paszkowskiDamian/tendon-torso/README.md

# Tendon Torso

An open, fully 3D-printed **tendon-driven torso with two arms**. All motors sit in the torso, and the tendons run hidden through the hollow core of every link, through shoulder, elbow and wrist, down to simple grippers.

We build it up one joint at a time.

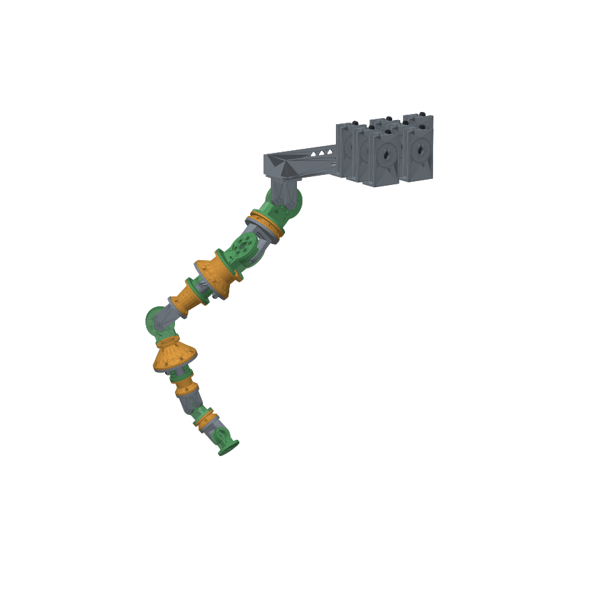
[picture p1: docs/img/arm_assembly.png]
7-DOF tendon arm


## Status

| Part | Status |
|---|---|
| [J1: 1-DOF tendon hinge test rig](joints/j1-hinge/) | designed, STL ready, **not printed/tested yet** |
| [J1-S: NEMA17, 6:1 tendon reduction, Bowden-ready center](joints/j1s-hinge/) | designed, STL ready, **not printed/tested yet** |
| [J1b: 2-DOF, J1-S elbow + J2 wrist, both motors remote (J2 via Bowden)](joints/j1b-2dof/) | designed, STL ready, **not printed/tested yet** |
| [**Two 7-DOF arms + grippers on a torso**](arm/), shoulder (3), elbow, forearm twist, wrist (2), two-finger gripper on one cord; 16 servo drive units in the torso column | designed, all 57 part files print-ready and CAD-checked, **not printed yet** |
| Second arm, motors | see [roadmap](docs/roadmap.md) |
| [MuJoCo simulation](docs/sim.md): both arms on the torso, pick-and-place scene, scripted IK demos, LeRobot dataset recording, ACT training + evaluation | runs; scripted demos 100 %, ACT policy trained in sim 84 % on unseen scenes |

## Interactive viewer

An animated 3D assembly showing how the tendons wind is in [`docs/viewer/`](docs/viewer/). Run `python3 -m http.server -d docs/viewer` and open http://localhost:8000.

## Repo layout

```
docs/research.md      existing open designs + why J1 looks the way it does
docs/roadmap.md       path to the torso, the tendon-routing problem
joints/j1-hinge/      J1 (servo, 1:1): CadQuery source, STL/STEP, build guide
joints/j1s-hinge/     J1-S (stepper, 6:1, Bowden center)
joints/j1b-2dof/      J1b: J1-S + J2 wrist module + Bowden drive module
joints/common/        shared CAD helpers
arm/                  the two 7-DOF arms + grippers: modules, links, gripper, drive units, torso, STLs, build guide
arm/kinematics.py     forward + inverse kinematics (python -m arm.ik X Y Z), see docs/kinematics.md
sim/                  MuJoCo model built from the CAD, pick-and-place env, demo recorder, policy evaluator (docs/sim.md)
tools/                preview renders + collision / clearance checks
```

## Building the CAD

Everything is parametric Python ([CadQuery](https://cadquery.readthedocs.io/)). Change a number, then regenerate:

```bash
python3 -m venv .venv && .venv/bin/pip install -r requirements.txt
.venv/bin/python joints/j1-hinge/j1_hinge.py
.venv/bin/python tools/render.py
```

STEP files open in Fusion, FreeCAD, Onshape or Rhino.

## License

[MIT](LICENSE): use it, remix it, sell it, just keep the notice. Contributions and build reports are welcome.
