paszkowskiDamian/tendon-torso/docs/loads_report.txt

Arm mass: 1039 g printed (links 15%, modules 25% infill) + 593 g hardware = 1.63 kg  (+ 0.3 kg payload at the tool)

element         mass g
S1                 317
link_s1_s2          62
S2                 306
link_s2_s3          77
S3                 173
link_upper          55
E                  150
link_e_f            62
F                  136
link_forearm        32
W1                  95
link_w1_w2          25
W2                  91
gripper             51

Worst case over the workspace (1500 random poses + horizontal poses):
joint torque N*m   cord N  knob N  bearing N   pose (S1..W2)
S1          8.29      217    28.1        221   [90.0, 0.0, 0.0, 0.0, 0.0, 0.0, 0.0]
S2          5.72      156    20.1        202   [0.0, 90.0, 0.0, 0.0, 0.0, 0.0, 0.0]
S3          2.48      109    14.0        183   [68.0, 70.0, -70.0, 94.0, 1.0, 2.0, -11.0]
E           2.52       90    11.6        131   [90.0, 0.0, 0.0, 0.0, 0.0, 0.0, 0.0]
F           0.73       49     6.3         85   [112.0, -5.0, 70.0, 38.0, 39.0, -60.0, -3.0]
W1          0.86       63     8.2         73   [90.0, 0.0, 0.0, 0.0, 0.0, 0.0, 0.0]
W2          0.38       39     5.0         46   [0.0, 90.0, 0.0, 0.0, 0.0, 0.0, 0.0]

element         bend N*m  stress MPa  bolt N
S1                  8.29                  45
link_s1_s2          7.05         0.8      38
S2                  6.71                  36
link_s2_s3          4.91         0.5      27
S3                  4.20                  23
link_upper          3.68         1.4      25
E                   3.08                  57
link_e_f            2.06         0.8      38
F                   1.65                   9
link_forearm        1.34         0.5      25
W1                  1.11                  21
link_w1_w2          0.67         0.3      12
W2                  0.57                  11
gripper             0.23                   4
