paszkowskiDamian/tendon-torso/docs/img/j1_base.png

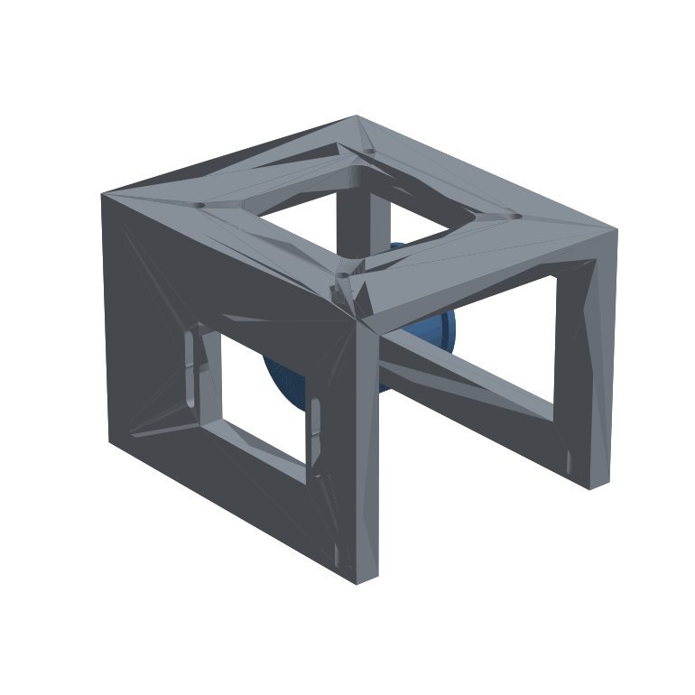
docs/img/j1_base.png
