paszkowskiDamian/tendon-torso/docs/img/j1_proximal.png

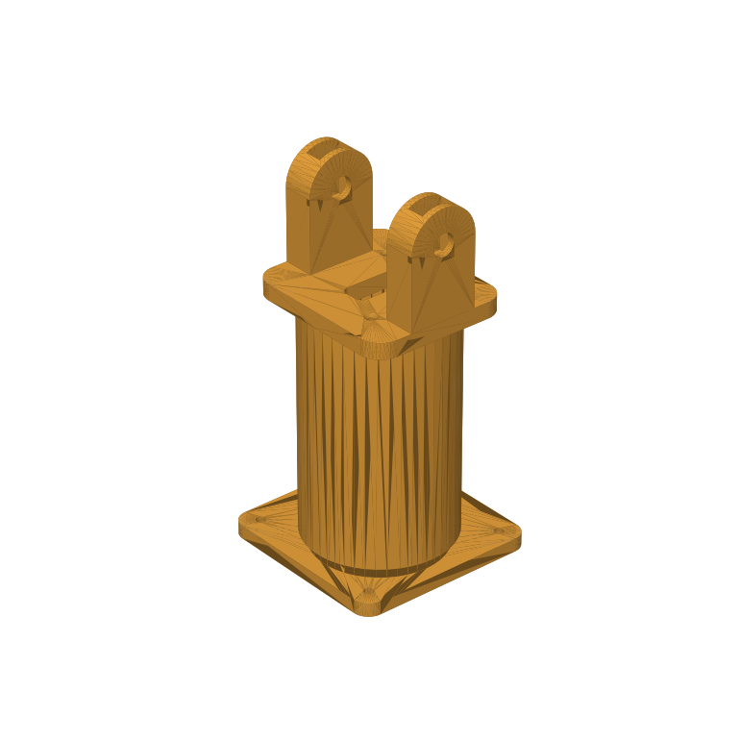
docs/img/j1_proximal.png
