paszkowskiDamian/tendon-torso/docs/img/j1_spool.png

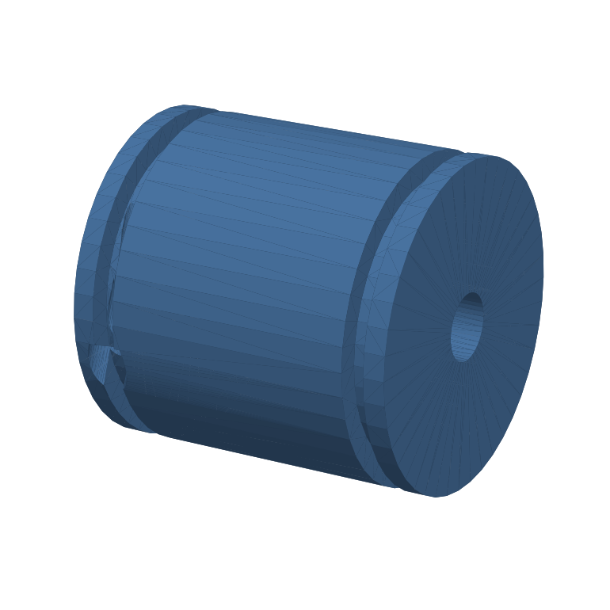
docs/img/j1_spool.png
