paszkowskiDamian/tendon-torso/docs/img/j1s_base.png

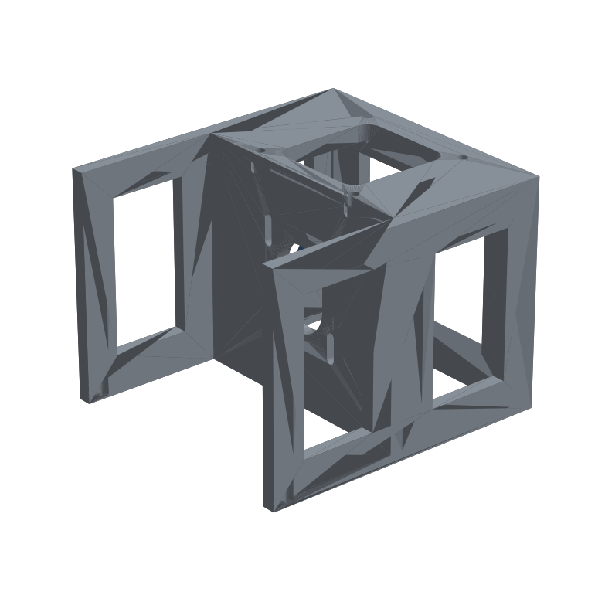
docs/img/j1s_base.png
