paszkowskiDamian/tendon-torso/docs/img/j1s_spool.png

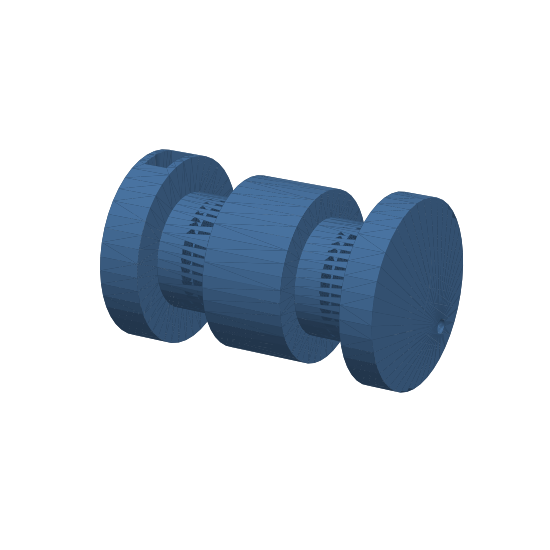
docs/img/j1s_spool.png
