paszkowskiDamian/tendon-torso/docs/img/workspace_heights.png

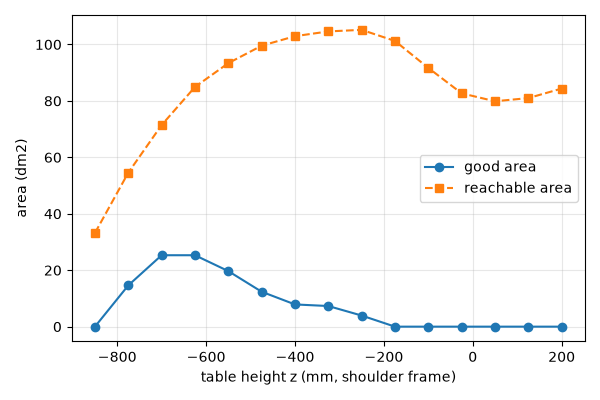
docs/img/workspace_heights.png
