paszkowskiDamian/tendon-torso/docs/img/workspace_plane.png

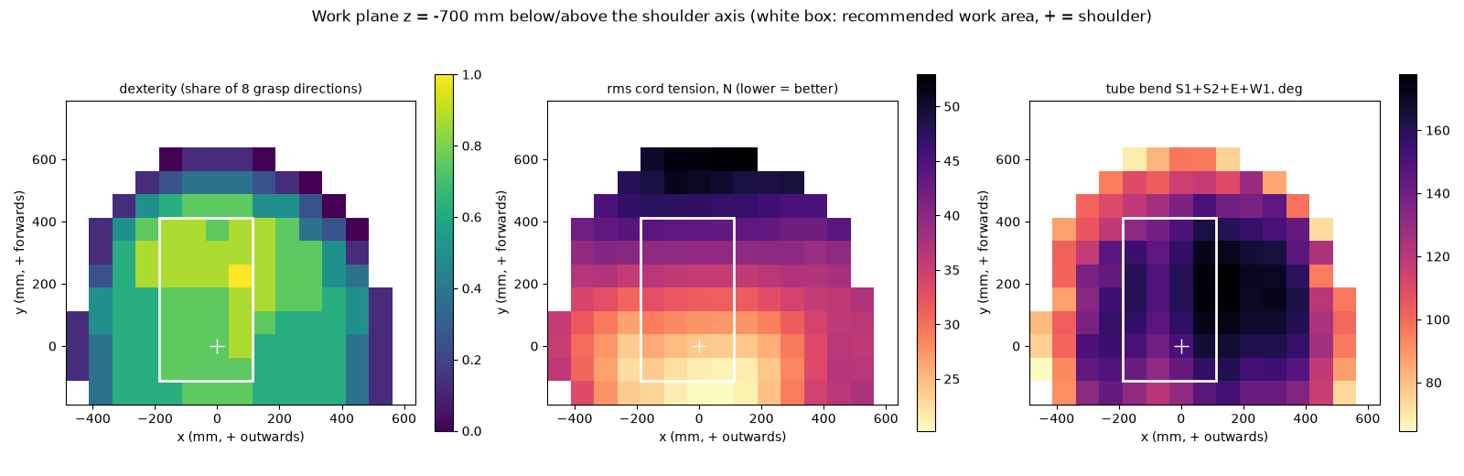
docs/img/workspace_plane.png
