paszkowskiDamian/tendon-torso/joints/j1b-2dof/stl/assembly_preview.step

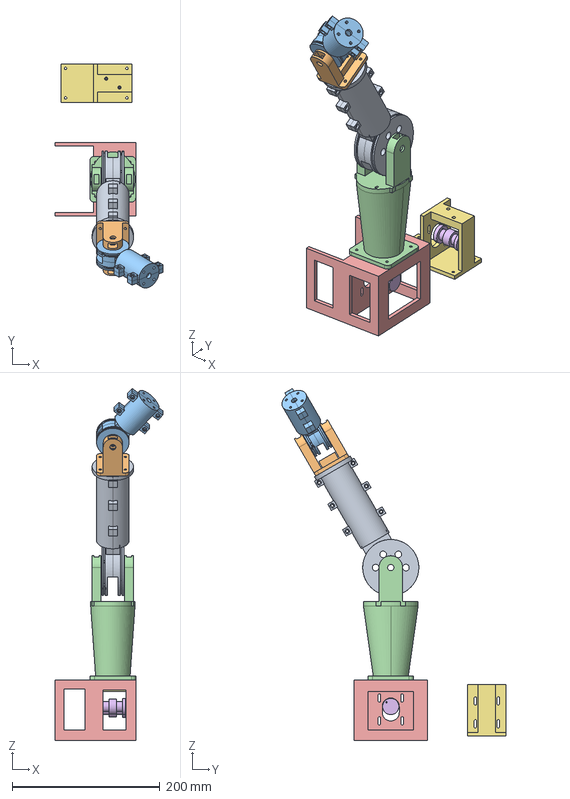
[picture p17: CAD file, 2026-11-10]
joints/j1b-2dof/stl/assembly_preview.step
145.6 x 303.2 x 476.3 mm
