paszkowskiDamian/tendon-torso/joints/j1s-hinge/stl/assembly_preview.step

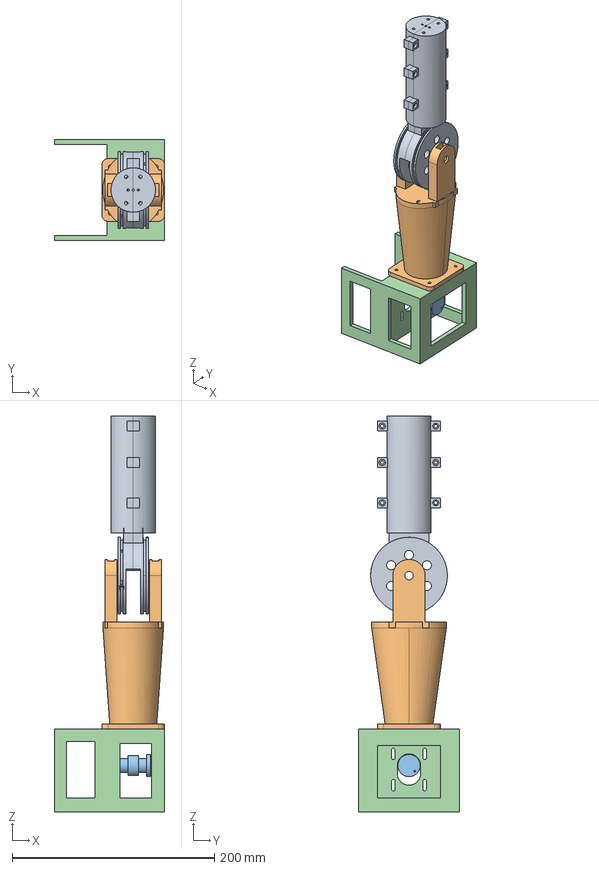
[picture p18: CAD file, 2026-11-10]
joints/j1s-hinge/stl/assembly_preview.step
109.0 x 100.0 x 392.0 mm
