paszkowskiDamian/tendon-torso/arm/stl/torso_saddle.stl

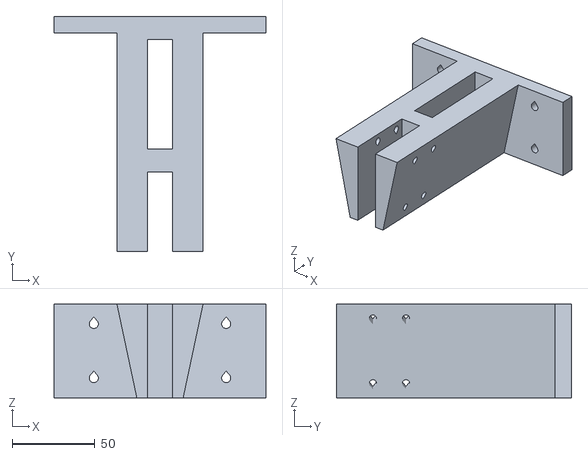
[picture p19: CAD file, 2026-11-11]
arm/stl/torso_saddle.stl
128.0 x 142.0 x 56.7
