paszkowskiDamian/tendon-torso/joints/j1b-2dof/stl/j2_mount.step

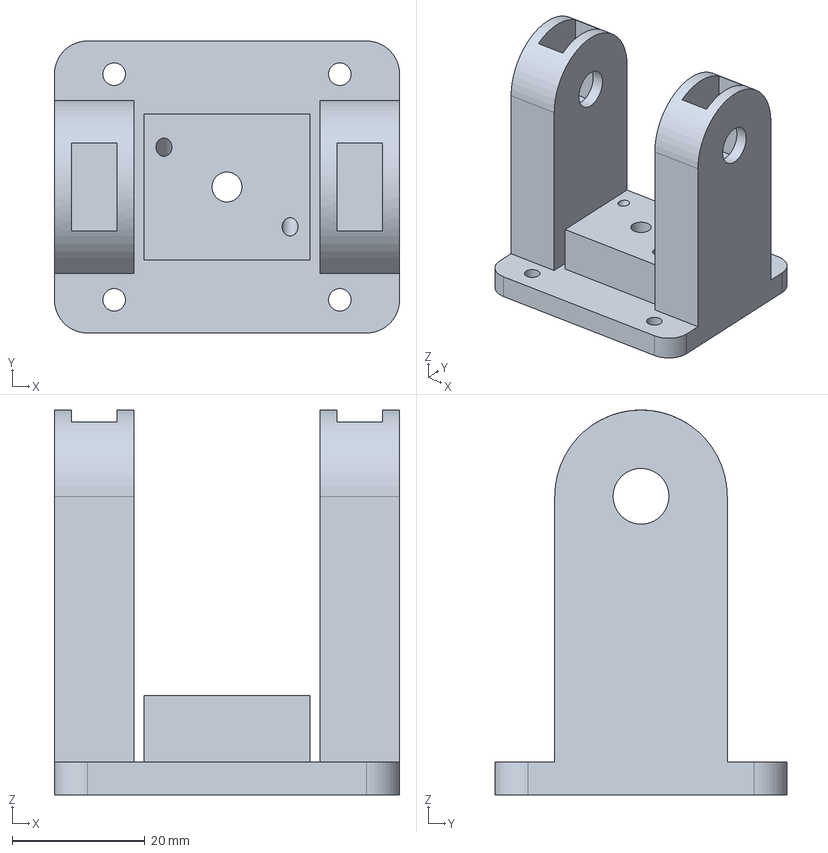
[picture p20: CAD file, 2026-11-10]
joints/j1b-2dof/stl/j2_mount.step
52.0 x 44.0 x 58.0 mm
