paszkowskiDamian/tendon-torso/joints/j1s-hinge/stl/proximal.step

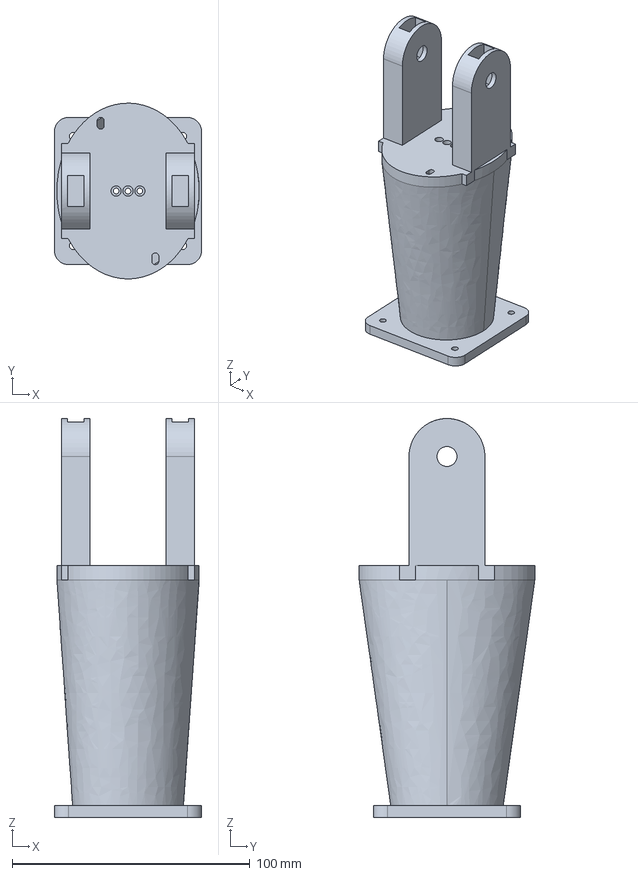
[picture p21: CAD file, 2026-11-10]
joints/j1s-hinge/stl/proximal.step
62.0 x 74.0 x 168.0 mm
