paszkowskiDamian/tendon-torso/sim/assets/s2_base_l.stl

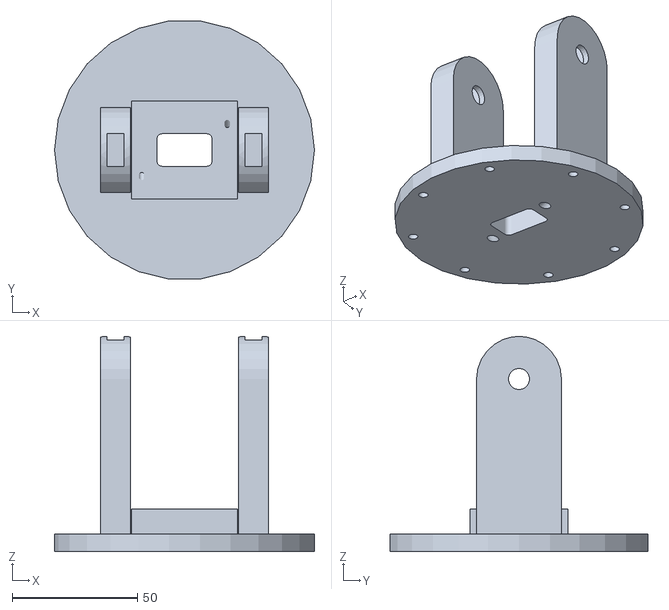
[picture p22: CAD file, 2026-11-11]
sim/assets/s2_base_l.stl
104.0 x 103.2 x 86.0
