paszkowskiDamian/tendon-torso/arm/stl/balance_post.stl

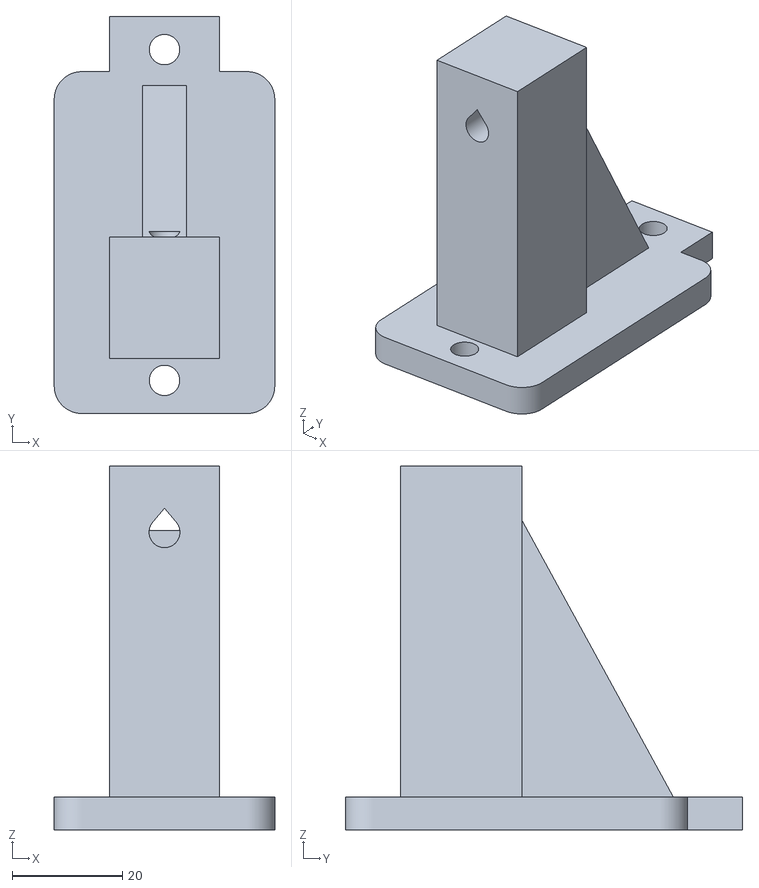
[picture p23: CAD file, 2026-11-11]
arm/stl/balance_post.stl
40.0 x 72.0 x 66.0
