paszkowskiDamian/tendon-torso/joints/j1b-2dof/stl/j2_distal_half.step

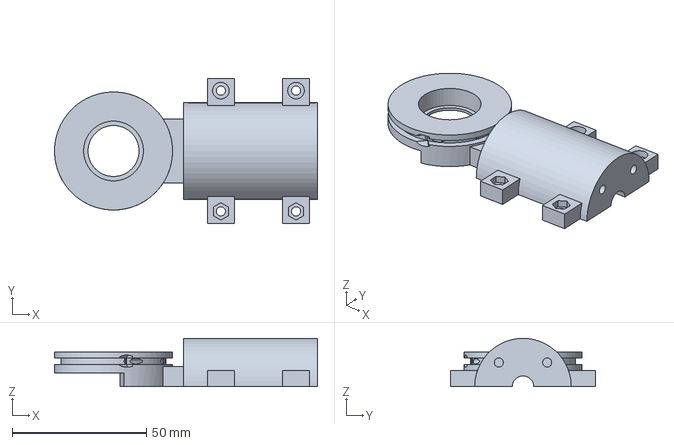
[picture p24: CAD file, 2026-11-10]
joints/j1b-2dof/stl/j2_distal_half.step
98.0 x 54.0 x 18.0 mm
