paszkowskiDamian/tendon-torso/joints/j1s-hinge/stl/base.step

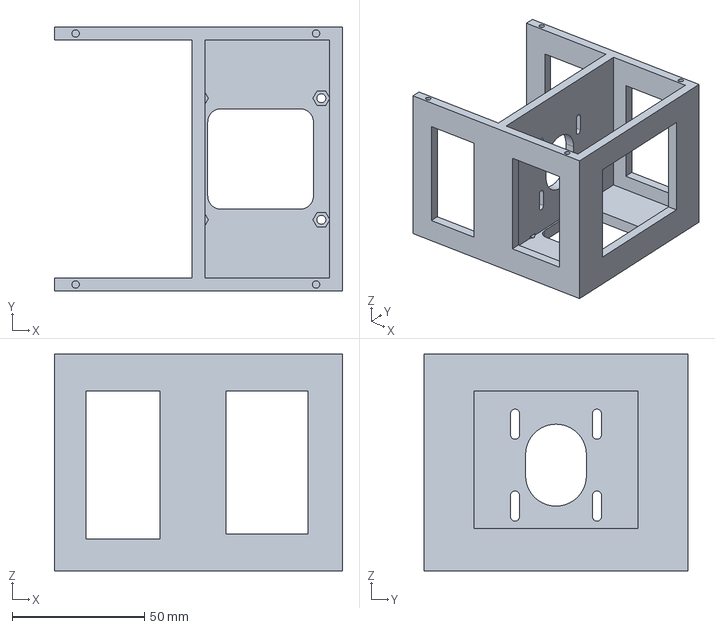
[picture p25: CAD file, 2026-11-10]
joints/j1s-hinge/stl/base.step
109.0 x 100.0 x 82.0 mm
