paszkowskiDamian/tendon-torso/sim/assets/s3_rotor_l.stl

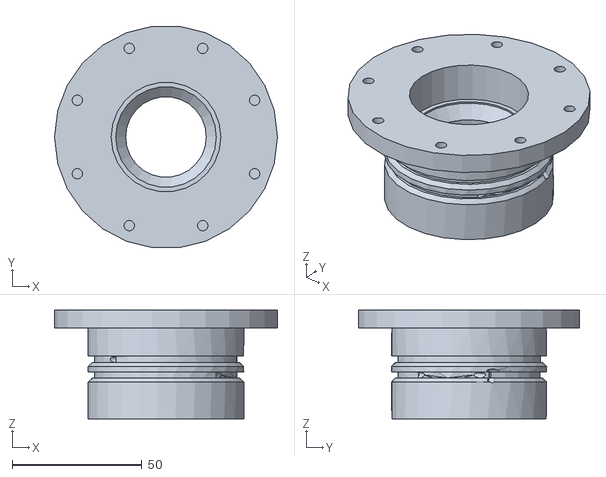
[picture p26: CAD file, 2026-11-11]
sim/assets/s3_rotor_l.stl
86.0 x 85.4 x 42.0
