paszkowskiDamian/tendon-torso/arm/stl/torso_shoulder_beam.stl

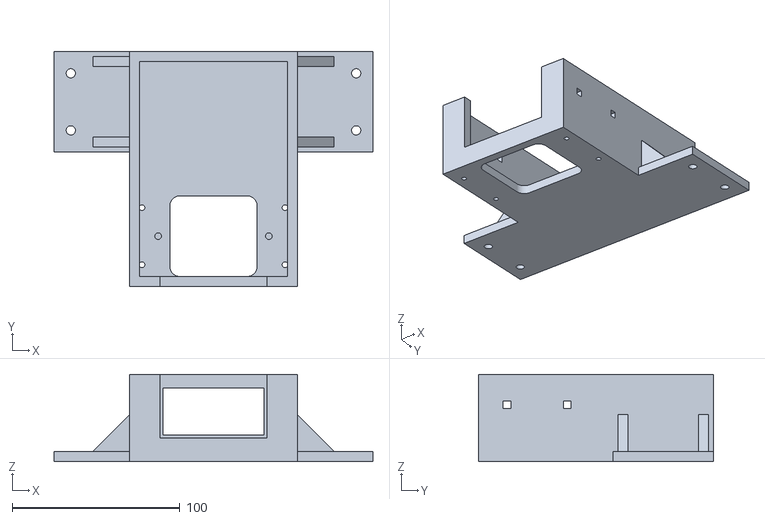
[picture p27: CAD file, 2026-11-11]
arm/stl/torso_shoulder_beam.stl
190.0 x 140.0 x 52.0
