paszkowskiDamian/tendon-torso/joints/j1s-hinge/stl/distal_half.step

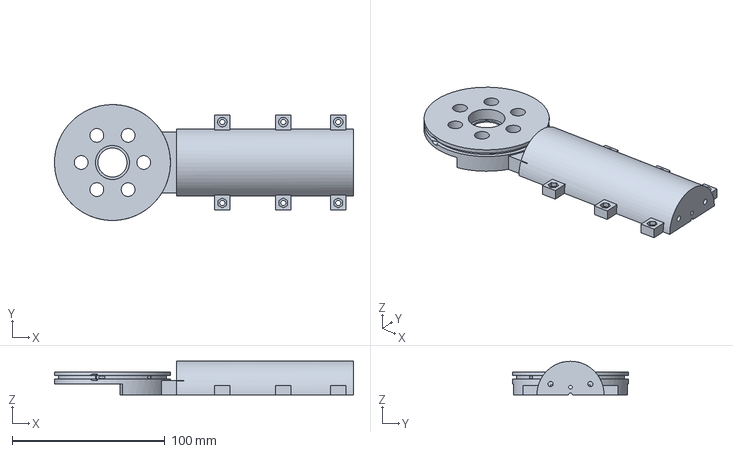
[picture p28: CAD file, 2026-11-10]
joints/j1s-hinge/stl/distal_half.step
196.0 x 76.0 x 22.0 mm
