paszkowskiDamian/tendon-torso/sim/assets/gripper_finger_b_l.stl

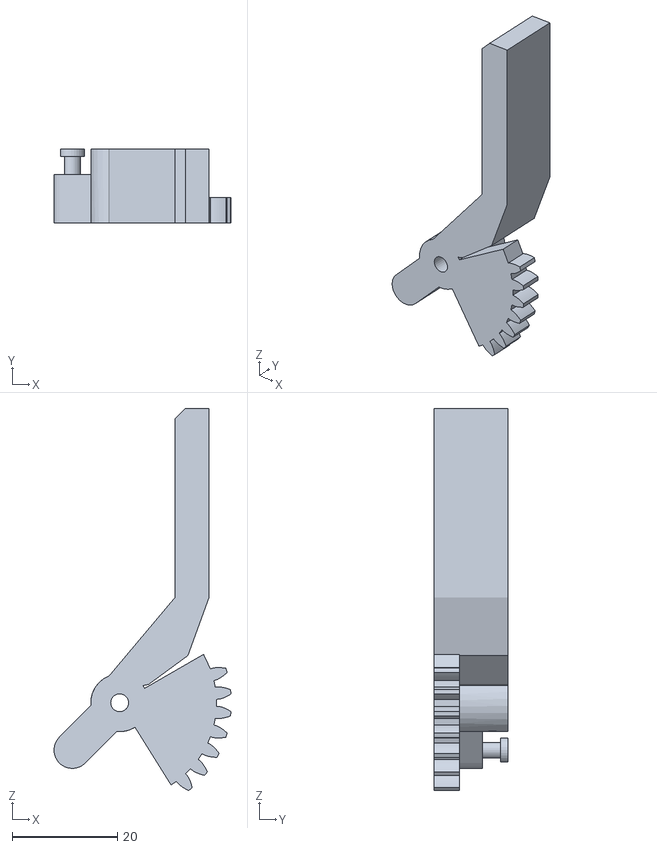
[picture p29: CAD file, 2026-11-11]
sim/assets/gripper_finger_b_l.stl
33.7 x 14.0 x 72.7
