paszkowskiDamian/tendon-torso/arm/stl/drive_adapter_sts3215.stl

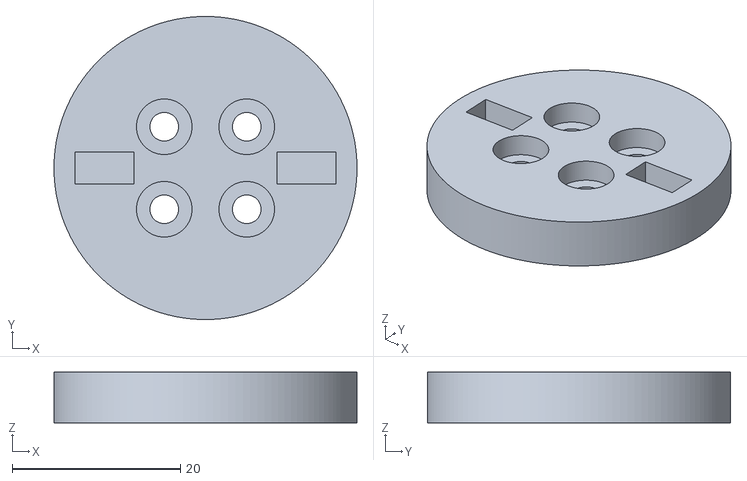
[picture p30: CAD file, 2026-11-11]
arm/stl/drive_adapter_sts3215.stl
36.0 x 36.0 x 6.00
