paszkowskiDamian/tendon-torso/joints/j1s-hinge/stl/spool.step

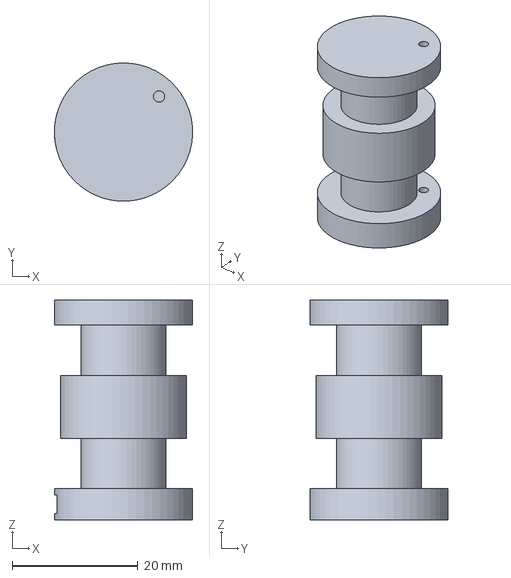
[picture p31: CAD file, 2026-11-10]
joints/j1s-hinge/stl/spool.step
22.0 x 22.0 x 35.0 mm
