paszkowskiDamian/tendon-torso/sim/assets/link_forearm_r.stl

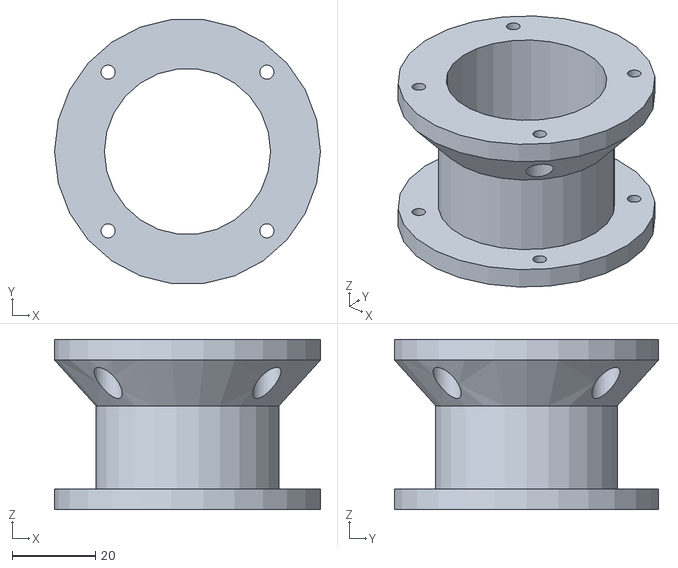
[picture p32: CAD file, 2026-11-11]
sim/assets/link_forearm_r.stl
64.0 x 63.5 x 41.0
