paszkowskiDamian/tendon-torso/arm/stl/torso_electronics_tray.stl

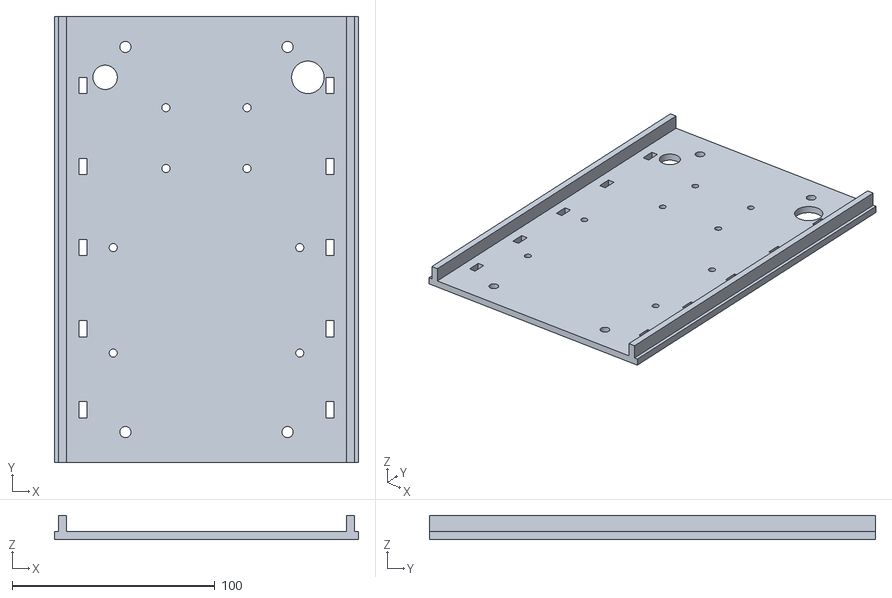
[picture p33: CAD file, 2026-11-11]
arm/stl/torso_electronics_tray.stl
150.0 x 220.0 x 12.0
