paszkowskiDamian/tendon-torso/joints/j1b-2dof/stl/bowden_drive.step

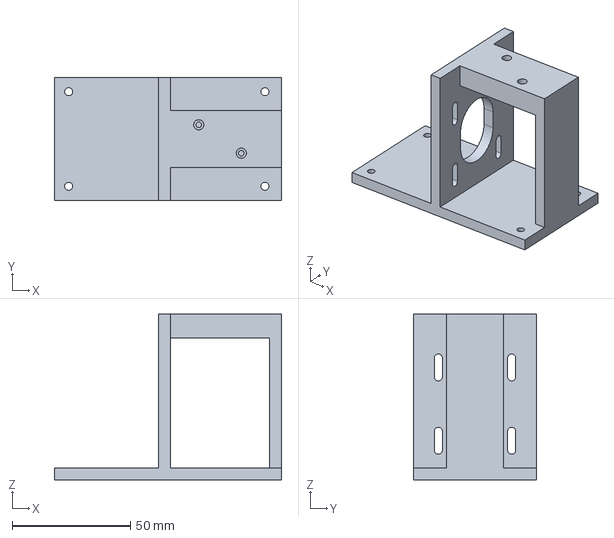
[picture p34: CAD file, 2026-11-10]
joints/j1b-2dof/stl/bowden_drive.step
96.0 x 52.0 x 70.0 mm
