paszkowskiDamian/tendon-torso/sim/assets/w1_base_l.stl

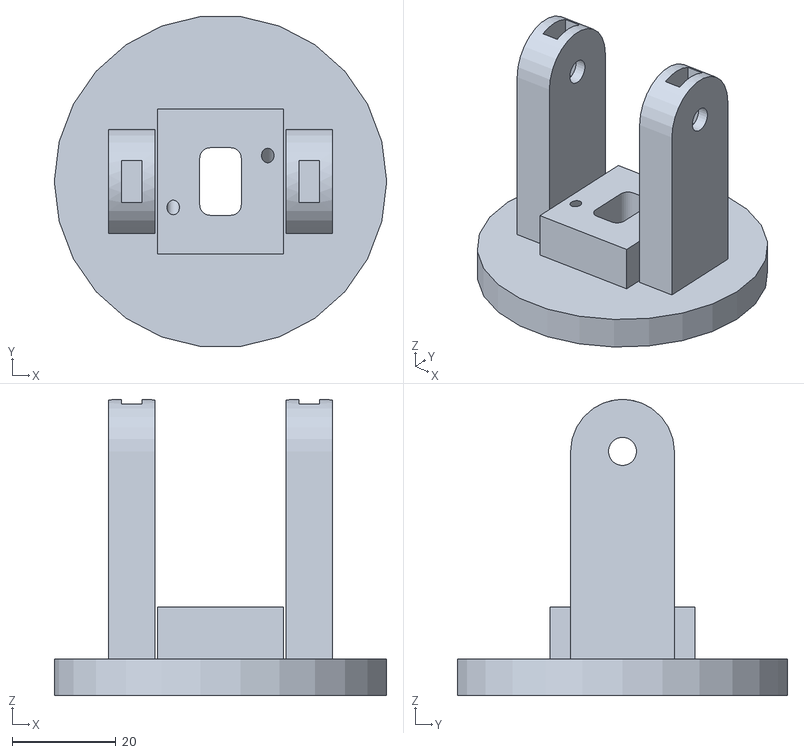
[picture p35: CAD file, 2026-11-11]
sim/assets/w1_base_l.stl
64.0 x 63.5 x 57.0
