paszkowskiDamian/tendon-torso/arm/stl/drive_frame.stl

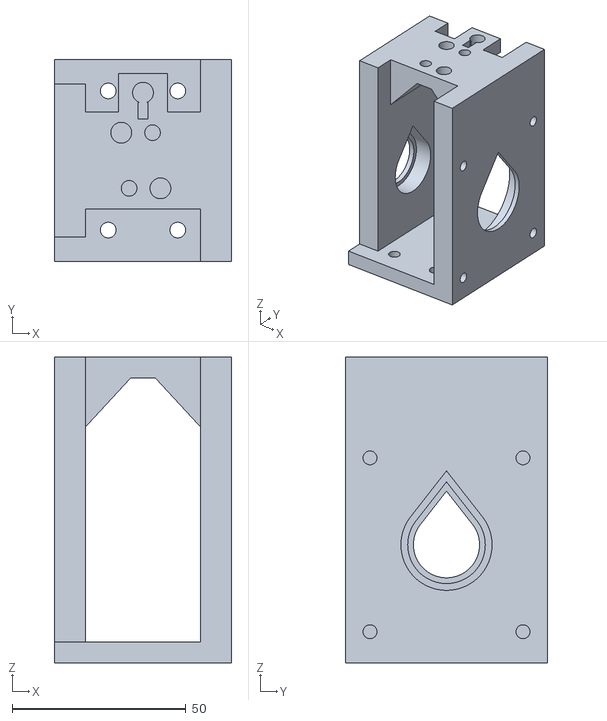
[picture p36: CAD file, 2026-11-11]
arm/stl/drive_frame.stl
51.0 x 58.0 x 88.0
