paszkowskiDamian/tendon-torso/joints/j1b-2dof/stl/j1_distal_half_mount.step

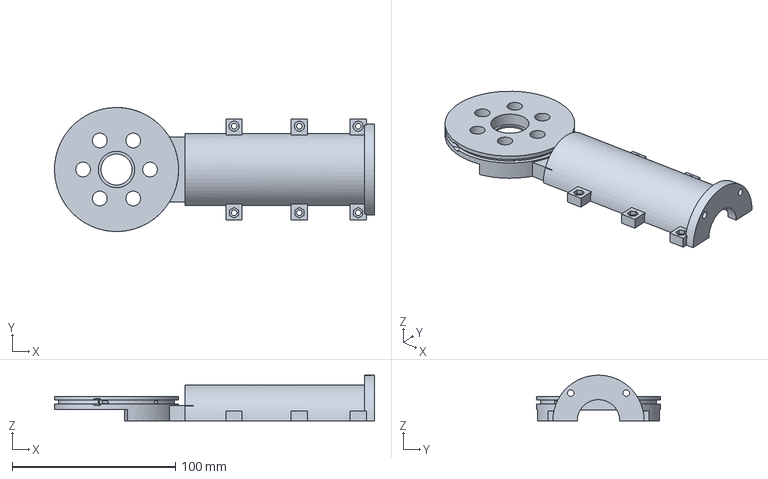
[picture p37: CAD file, 2026-11-10]
joints/j1b-2dof/stl/j1_distal_half_mount.step
196.0 x 76.0 x 28.0 mm
