paszkowskiDamian/tendon-torso/arm/stl/torso_shoulder_comb.stl

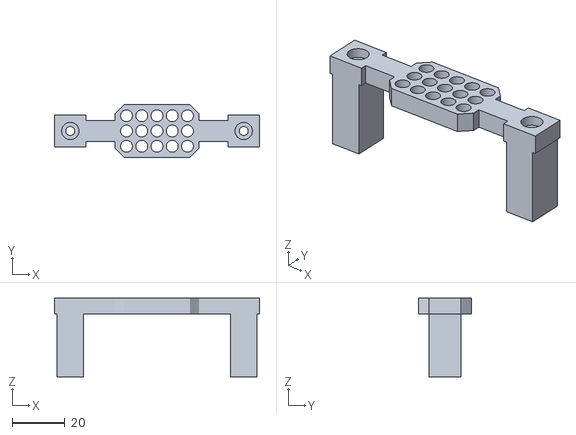
[picture p38: CAD file, 2026-11-11]
arm/stl/torso_shoulder_comb.stl
78.0 x 20.0 x 30.0
