paszkowskiDamian/tendon-torso/sim/assets/gripper_pad_b_r.stl

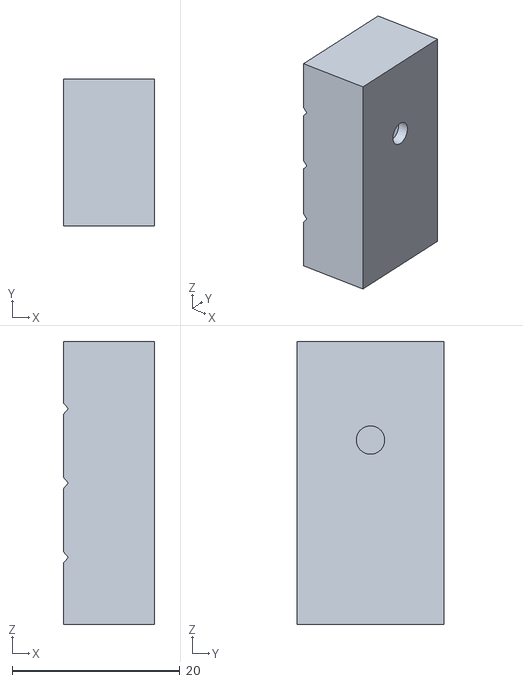
[picture p39: CAD file, 2026-11-11]
sim/assets/gripper_pad_b_r.stl
10.9 x 17.5 x 33.8
