paszkowskiDamian/tendon-torso/arm/stl/drive_adapter_dmj4310.stl

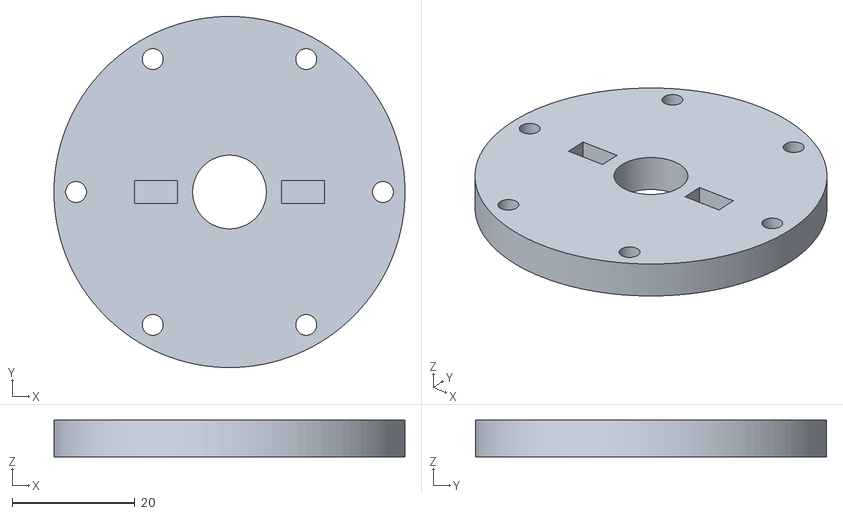
[picture p40: CAD file, 2026-11-11]
arm/stl/drive_adapter_dmj4310.stl
57.2 x 57.2 x 6.00
