paszkowskiDamian/tendon-torso/sim/assets/s2_rotor_a_l.stl

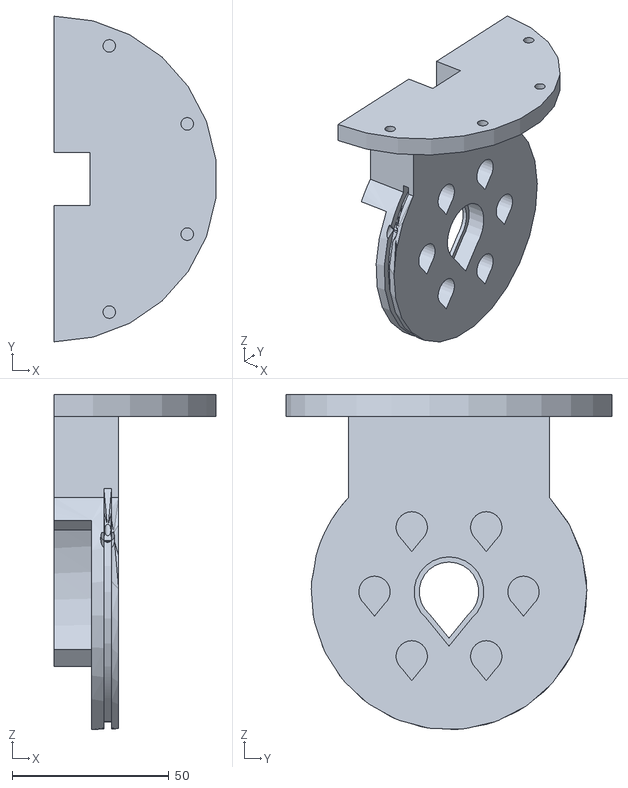
[picture p41: CAD file, 2026-11-11]
sim/assets/s2_rotor_a_l.stl
51.6 x 104.0 x 107.0
