paszkowskiDamian/tendon-torso/arm/stl/torso_s1_hanger.stl

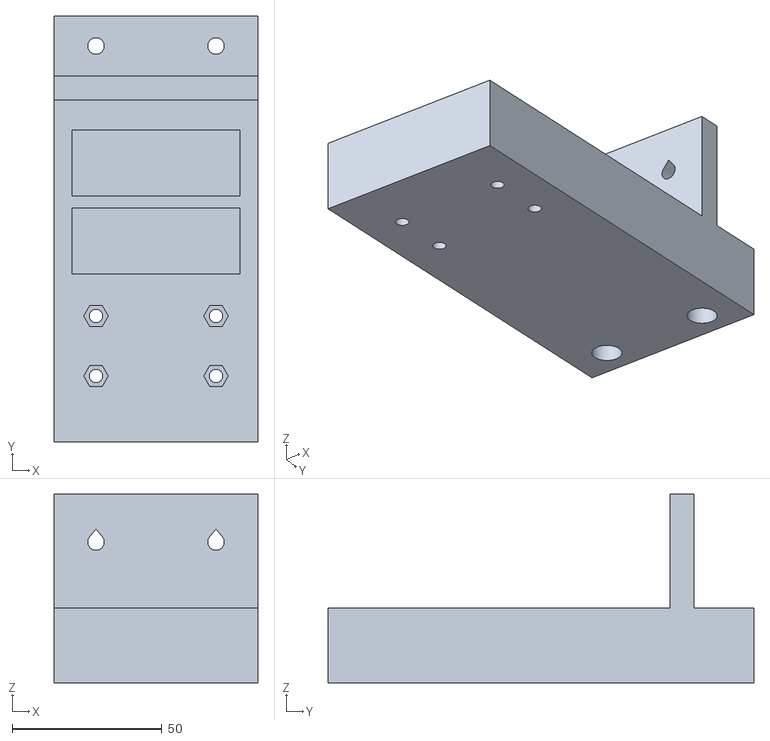
[picture p42: CAD file, 2026-11-11]
arm/stl/torso_s1_hanger.stl
68.0 x 142.0 x 63.0
