paszkowskiDamian/tendon-torso/sim/assets/f_idler_b_l.stl

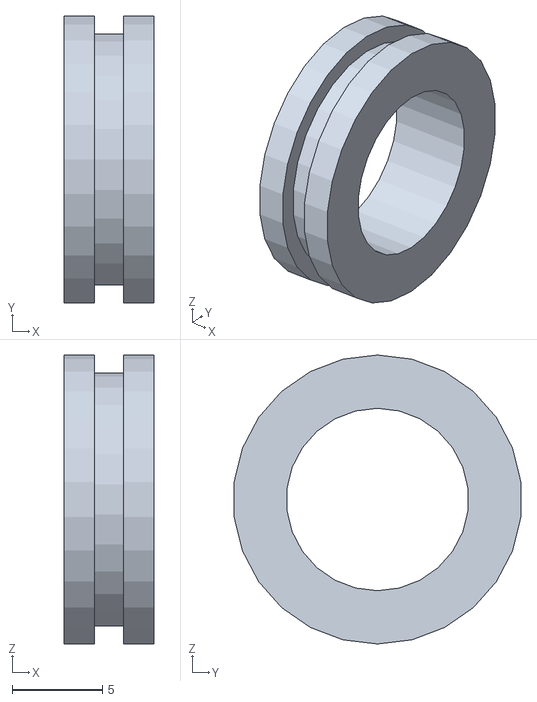
[picture p43: CAD file, 2026-11-11]
sim/assets/f_idler_b_l.stl
5.00 x 15.9 x 16.0
