paszkowskiDamian/tendon-torso/arm/stl/drive_cup_sts3250.stl

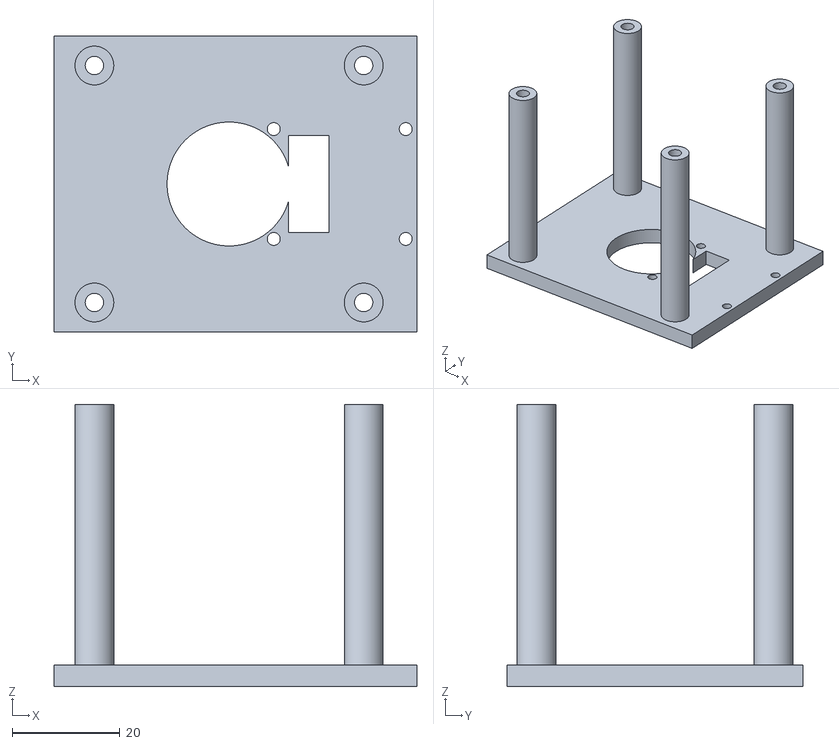
[picture p44: CAD file, 2026-11-11]
arm/stl/drive_cup_sts3250.stl
67.4 x 55.0 x 52.4
