paszkowskiDamian/tendon-torso/sim/assets/s3_stator_l.stl

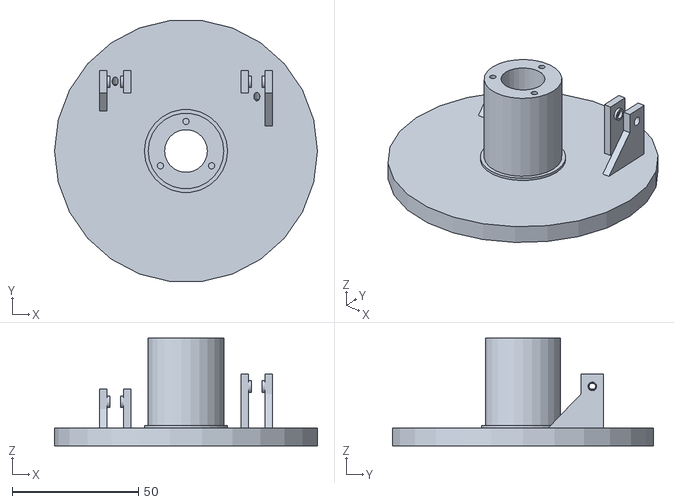
[picture p45: CAD file, 2026-11-11]
sim/assets/s3_stator_l.stl
104.0 x 103.2 x 42.6
