paszkowskiDamian/tendon-torso/sim/assets/gripper_finger_a_r.stl

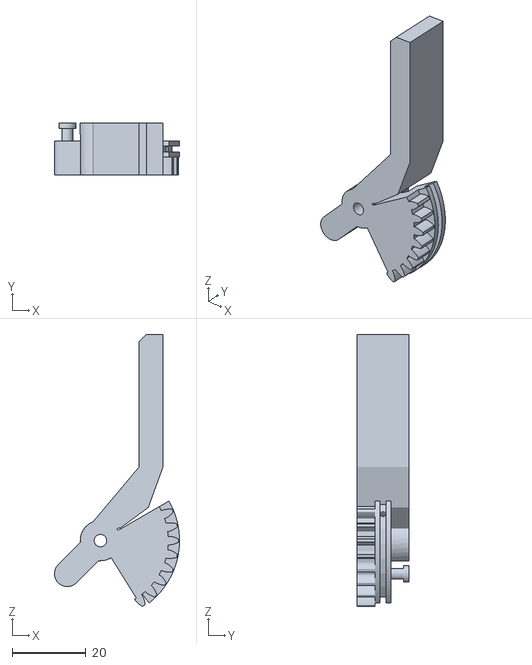
[picture p46: CAD file, 2026-11-11]
sim/assets/gripper_finger_a_r.stl
34.0 x 14.0 x 73.9
