paszkowskiDamian/tendon-torso/arm/stl/drive_spool.stl

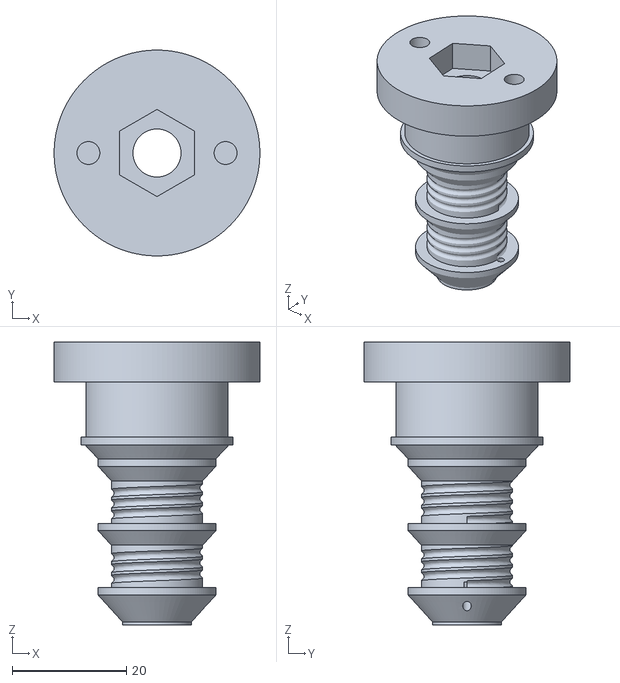
[picture p47: CAD file, 2026-11-11]
arm/stl/drive_spool.stl
36.0 x 36.0 x 49.5
