paszkowskiDamian/tendon-torso/sim/assets/link_e_f_r.stl

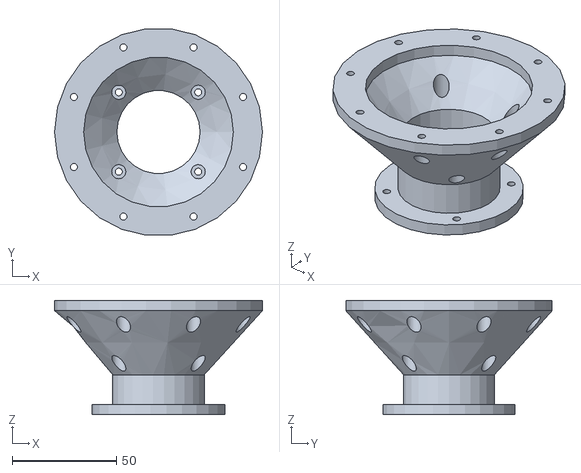
[picture p48: CAD file, 2026-11-11]
sim/assets/link_e_f_r.stl
100.0 x 99.3 x 55.0
