paszkowskiDamian/tendon-torso/arm/stl/drive_cup_dmj4310.stl

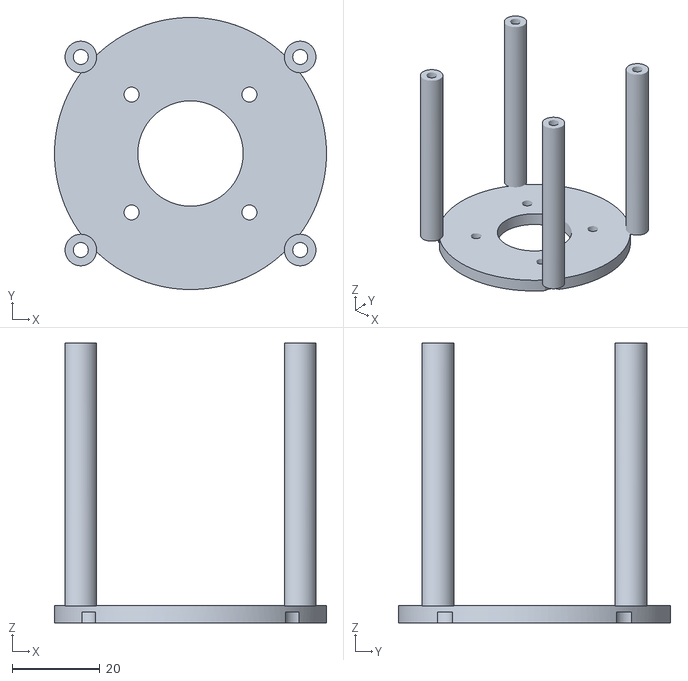
[picture p49: CAD file, 2026-11-11]
arm/stl/drive_cup_dmj4310.stl
62.0 x 62.0 x 63.8
