paszkowskiDamian/tendon-torso/sim/assets/f_stator_r.stl

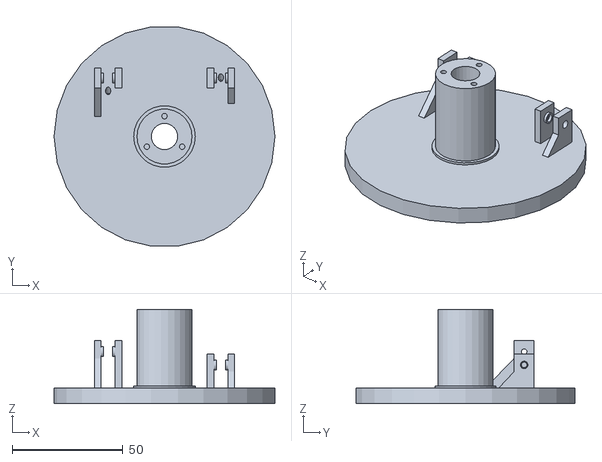
[picture p50: CAD file, 2026-11-11]
sim/assets/f_stator_r.stl
100.0 x 99.3 x 42.6
