paszkowskiDamian/tendon-torso/arm/stl/drive_cup_sts3095.stl

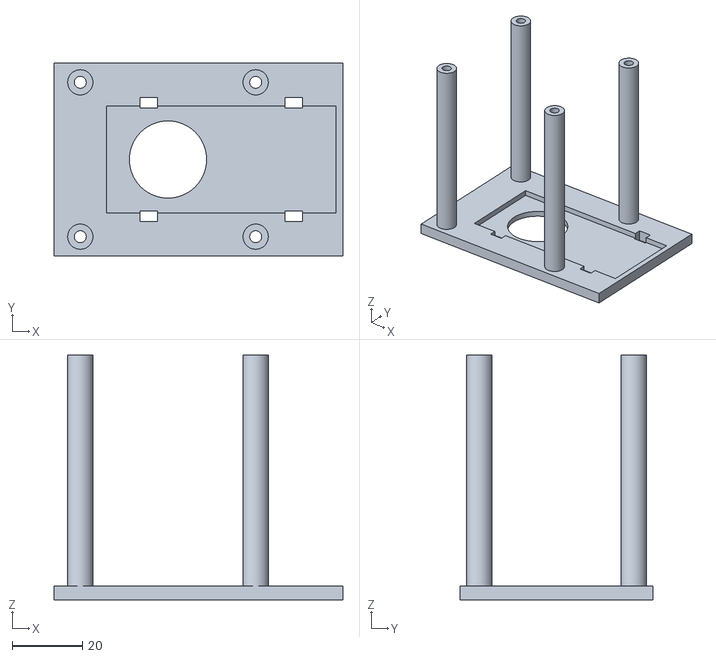
[picture p51: CAD file, 2026-11-11]
arm/stl/drive_cup_sts3095.stl
82.4 x 55.0 x 69.8
