paszkowskiDamian/tendon-torso/arm/stl/torso_estop_box.stl

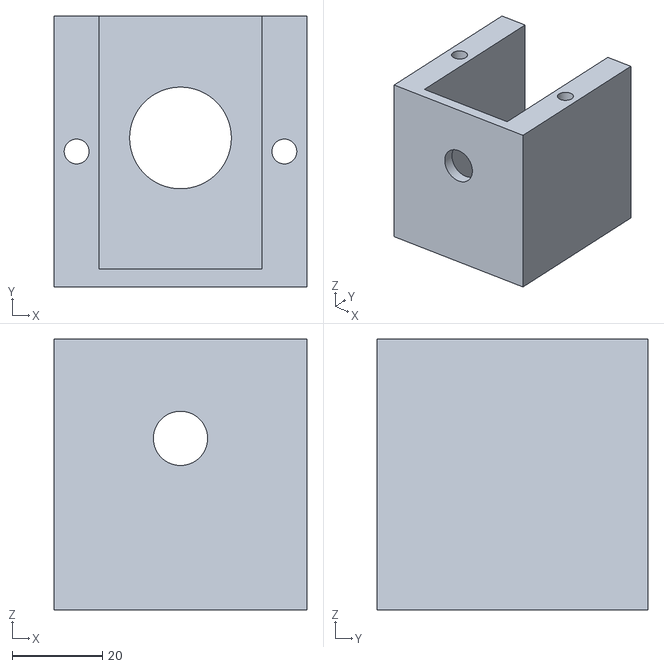
[picture p52: CAD file, 2026-11-11]
arm/stl/torso_estop_box.stl
56.0 x 60.0 x 60.0
