paszkowskiDamian/tendon-torso/arm/stl/w2_rotor_b.stl

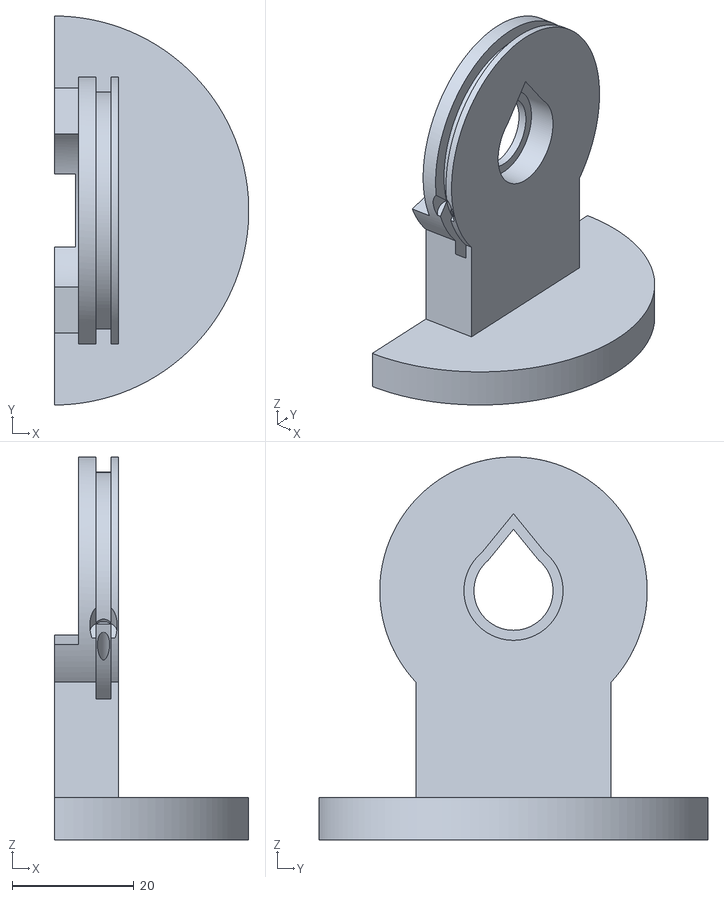
[picture p53: CAD file, 2026-11-11]
arm/stl/w2_rotor_b.stl
32.0 x 64.0 x 63.0
