paszkowskiDamian/tendon-torso/arm/stl/s2_rotor_b.stl

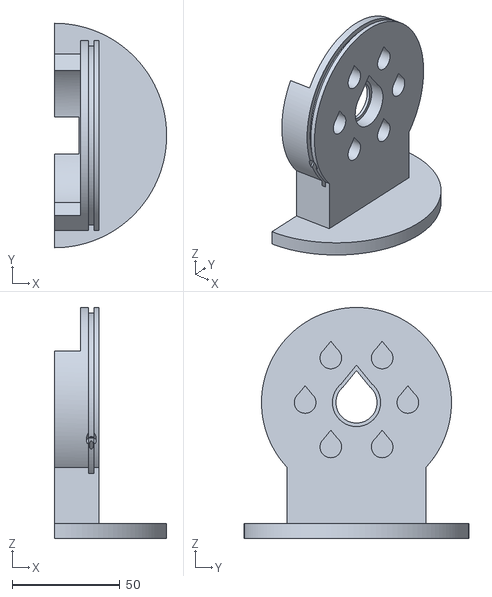
[picture p54: CAD file, 2026-11-11]
arm/stl/s2_rotor_b.stl
52.0 x 104.0 x 107.0
