paszkowskiDamian/tendon-torso/sim/assets/link_upper_l.stl

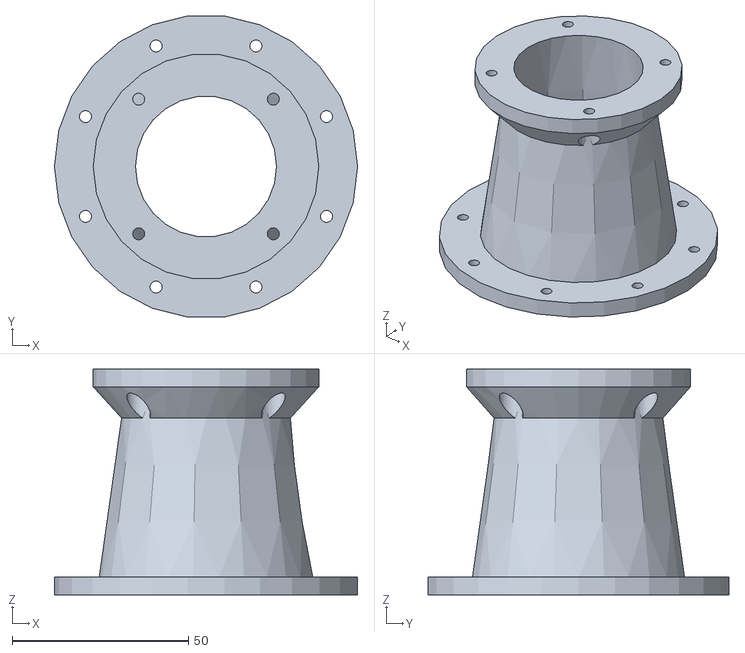
[picture p55: CAD file, 2026-11-11]
sim/assets/link_upper_l.stl
86.0 x 85.4 x 64.0
