paszkowskiDamian/tendon-torso/arm/stl/s1_rotor_b.stl

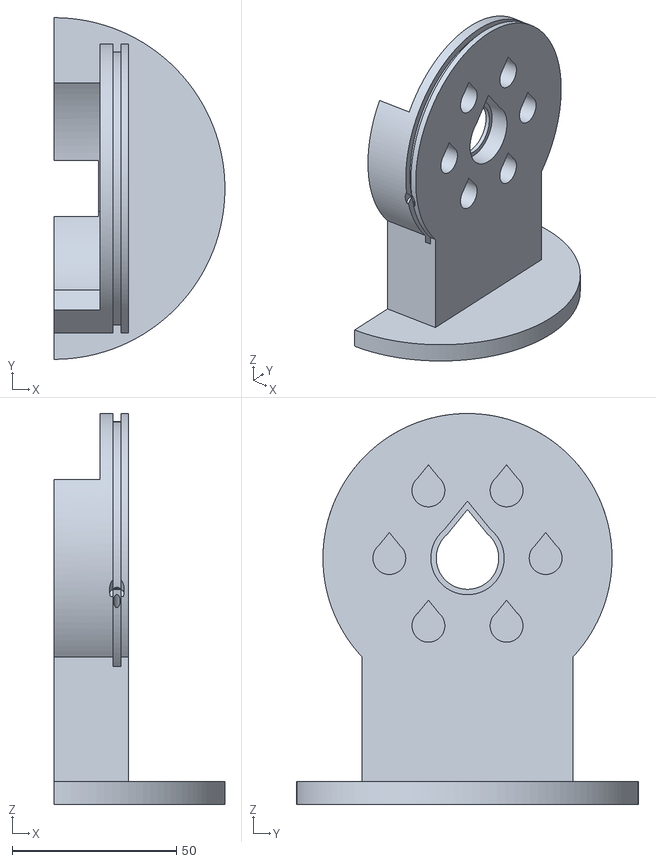
[picture p56: CAD file, 2026-11-11]
arm/stl/s1_rotor_b.stl
52.0 x 104.0 x 119.0
