paszkowskiDamian/tendon-torso/sim/assets/e_rotor_b_r.stl

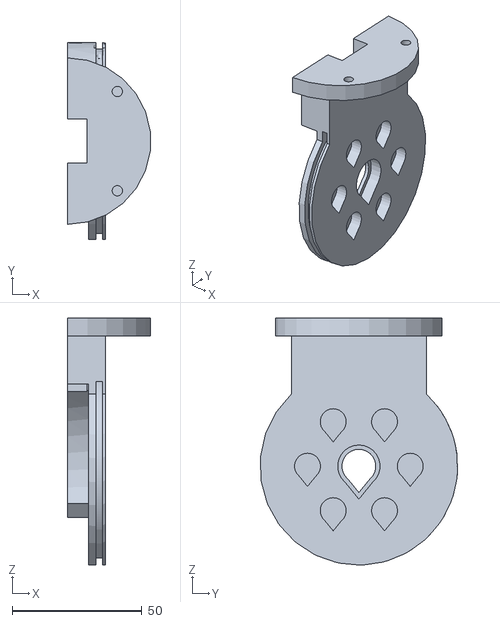
[picture p57: CAD file, 2026-11-11]
sim/assets/e_rotor_b_r.stl
31.8 x 75.8 x 95.0
