paszkowskiDamian/tendon-torso/sim/assets/f_retainer_r.stl

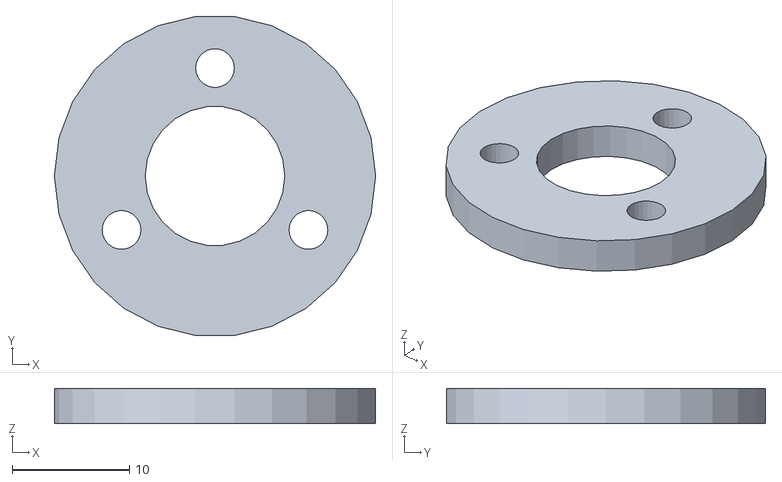
[picture p58: CAD file, 2026-11-11]
sim/assets/f_retainer_r.stl
27.4 x 27.2 x 3.00
