paszkowskiDamian/tendon-torso/arm/stl/e_base.stl

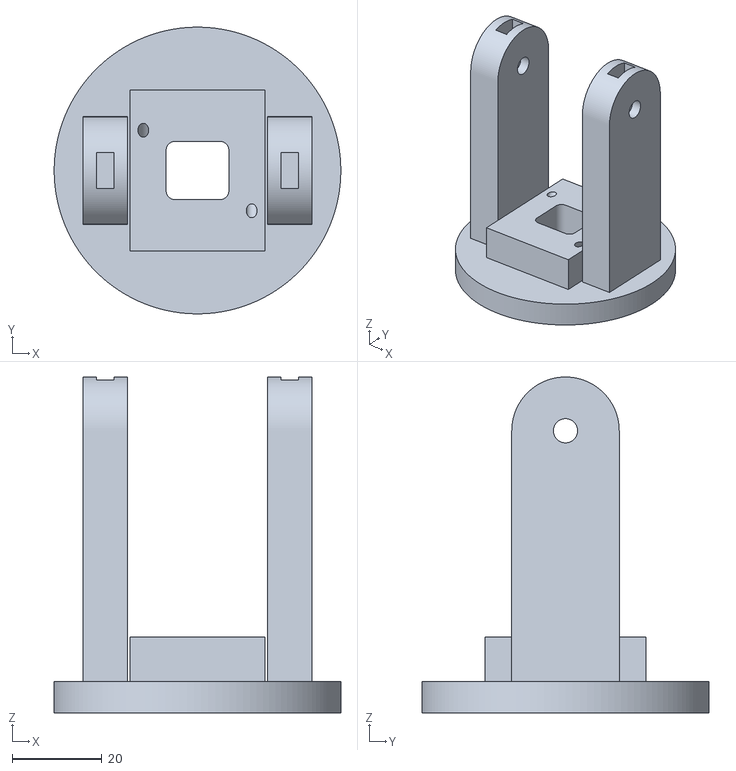
[picture p59: CAD file, 2026-11-11]
arm/stl/e_base.stl
64.0 x 64.0 x 75.0
