paszkowskiDamian/tendon-torso/sim/assets/gripper_palm_r.stl

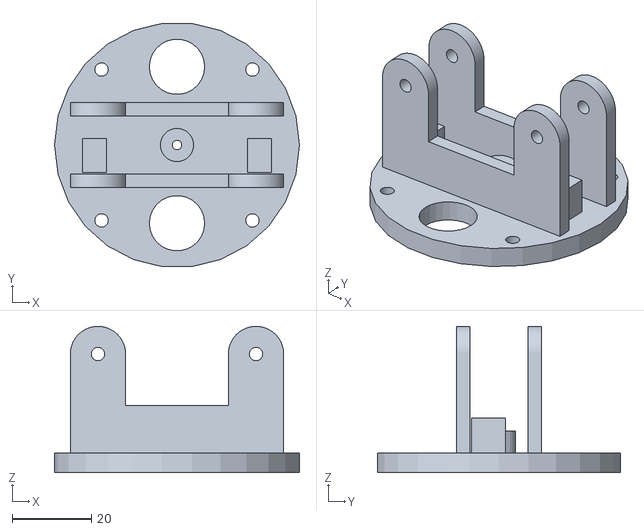
[picture p60: CAD file, 2026-11-11]
sim/assets/gripper_palm_r.stl
62.0 x 61.5 x 37.0
