paszkowskiDamian/tendon-torso/arm/stl/s1_base.stl

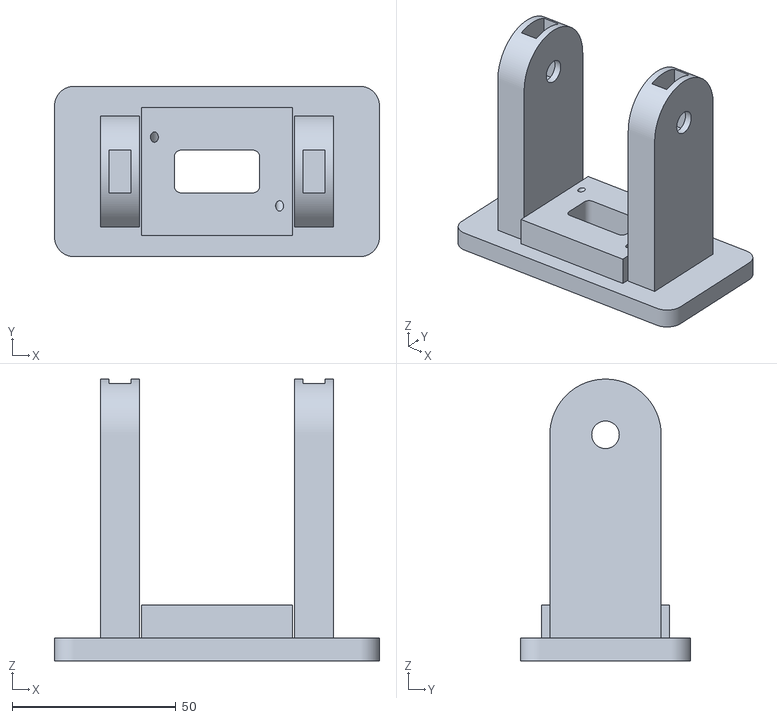
[picture p61: CAD file, 2026-11-11]
arm/stl/s1_base.stl
99.2 x 52.0 x 86.0
