paszkowskiDamian/tendon-torso/sim/assets/s3_retainer_l.stl

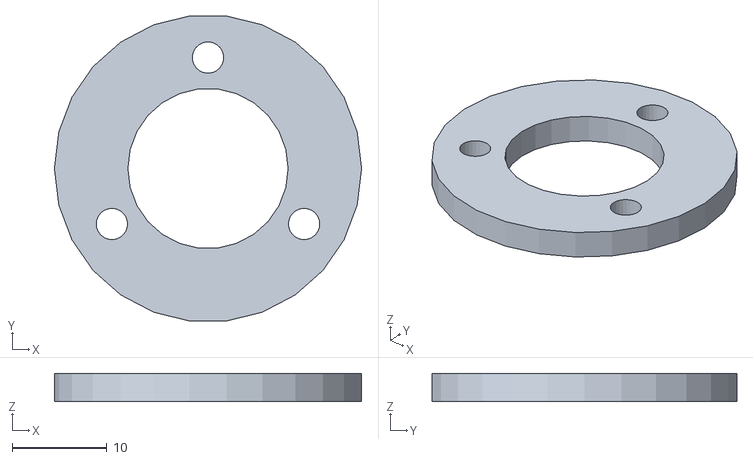
[picture p62: CAD file, 2026-11-11]
sim/assets/s3_retainer_l.stl
32.4 x 32.2 x 3.00
