paszkowskiDamian/tendon-torso/arm/stl/fitting_cord_thimble.stl

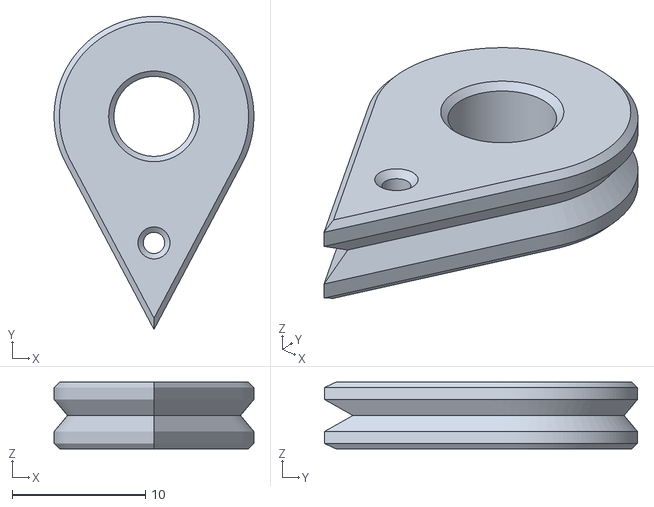
[picture p63: CAD file, 2026-11-11]
arm/stl/fitting_cord_thimble.stl
15.0 x 23.5 x 5.00
