paszkowskiDamian/tendon-torso/arm/stl/f_stator.stl

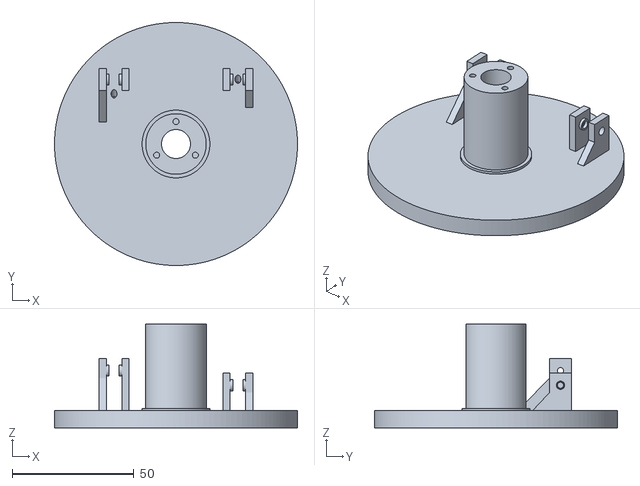
[picture p64: CAD file, 2026-11-11]
arm/stl/f_stator.stl
100.0 x 100.0 x 42.6
