paszkowskiDamian/tendon-torso/arm/stl/s3_stator.stl

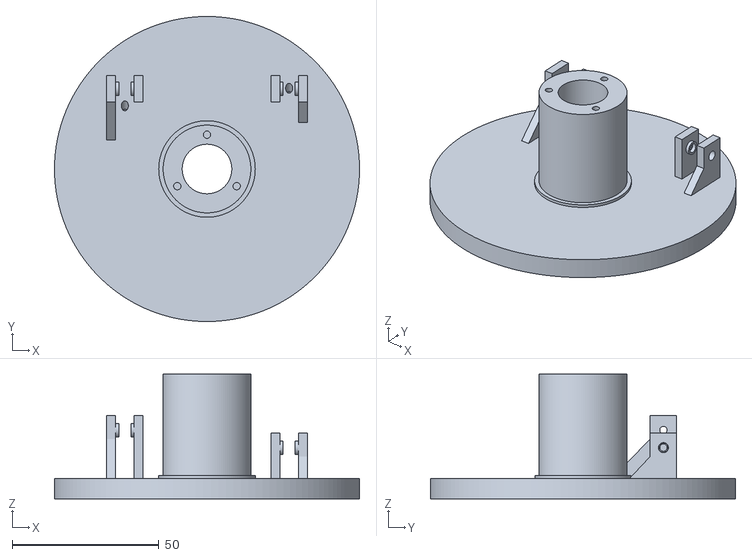
[picture p65: CAD file, 2026-11-11]
arm/stl/s3_stator.stl
104.0 x 104.0 x 42.6
