paszkowskiDamian/tendon-torso/arm/stl/link_e_f.stl

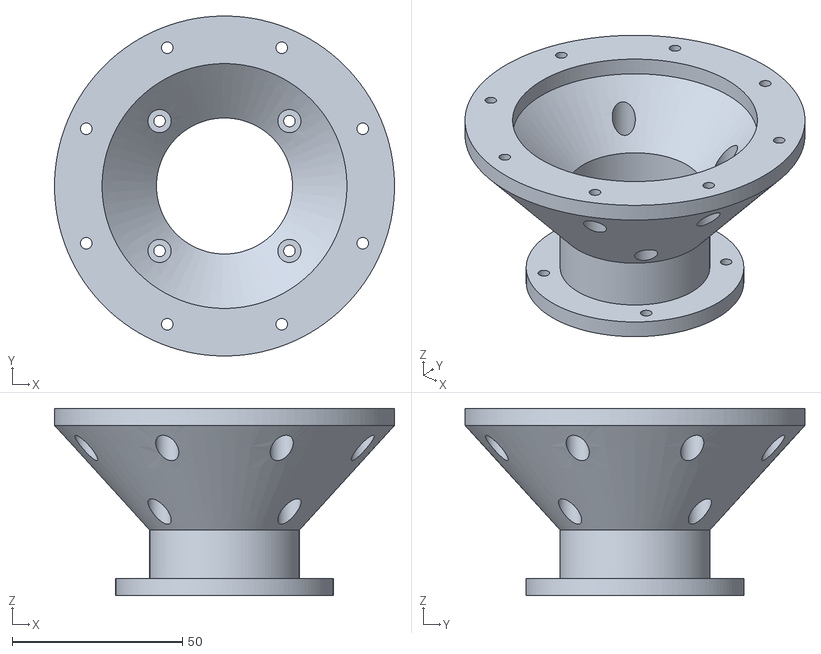
[picture p66: CAD file, 2026-11-11]
arm/stl/link_e_f.stl
100.0 x 100.0 x 55.0
