paszkowskiDamian/tendon-torso/arm/stl/link_s2_s3.stl

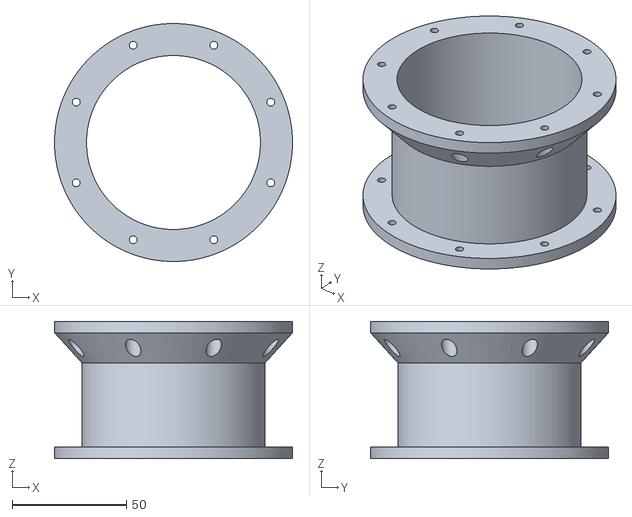
[picture p67: CAD file, 2026-11-11]
arm/stl/link_s2_s3.stl
104.0 x 104.0 x 60.0
