paszkowskiDamian/tendon-torso/sim/assets/link_w1_w2_l.stl

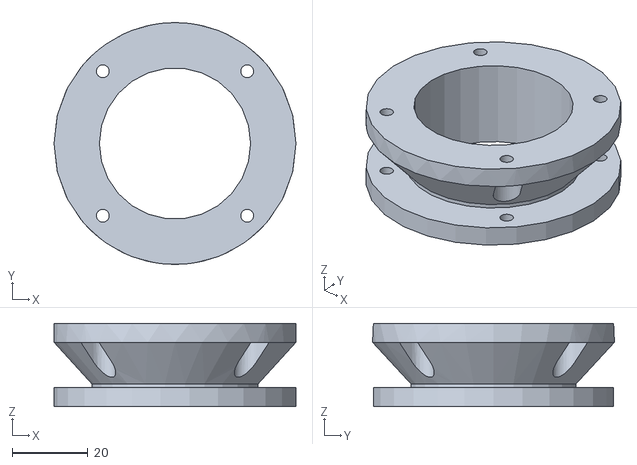
[picture p68: CAD file, 2026-11-11]
sim/assets/link_w1_w2_l.stl
64.0 x 64.0 x 22.0
