paszkowskiDamian/tendon-torso/arm/stl/link_s1_s2.stl

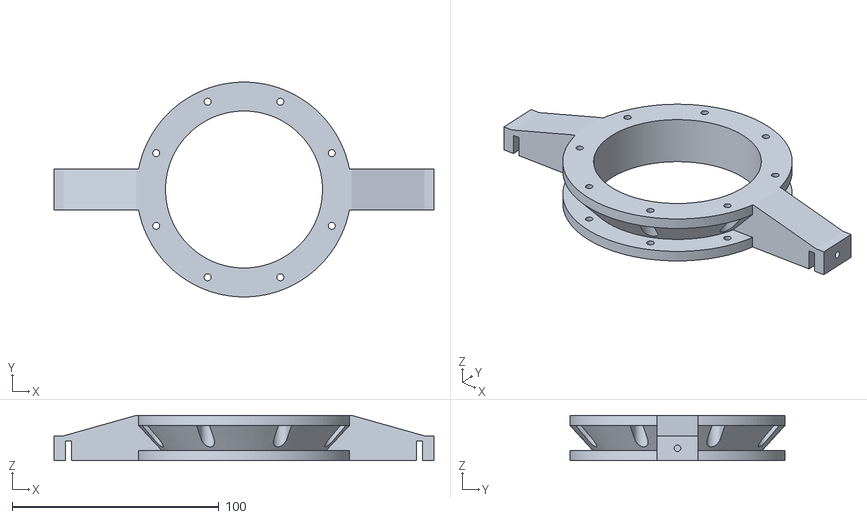
[picture p69: CAD file, 2026-11-11]
arm/stl/link_s1_s2.stl
184.0 x 104.0 x 22.0
