paszkowskiDamian/tendon-torso/arm/stl/link_upper.stl

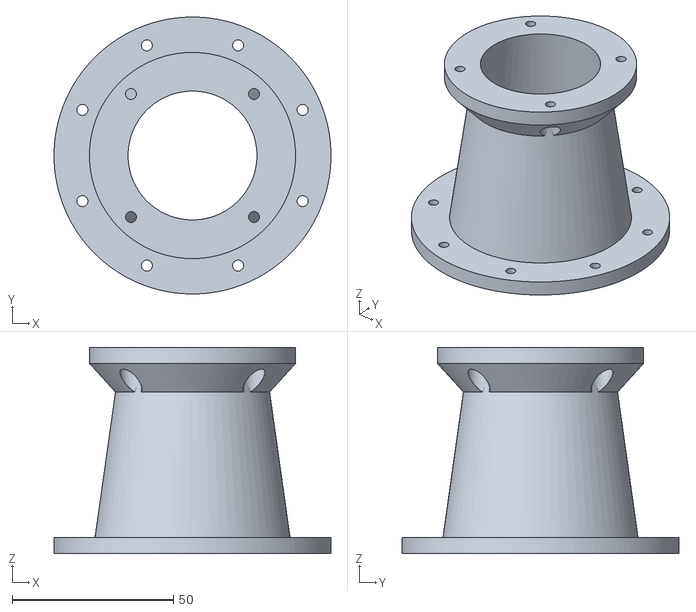
[picture p70: CAD file, 2026-11-11]
arm/stl/link_upper.stl
86.0 x 86.0 x 64.0
