paszkowskiDamian/tendon-torso/arm/stl/balance_mast_l.stl

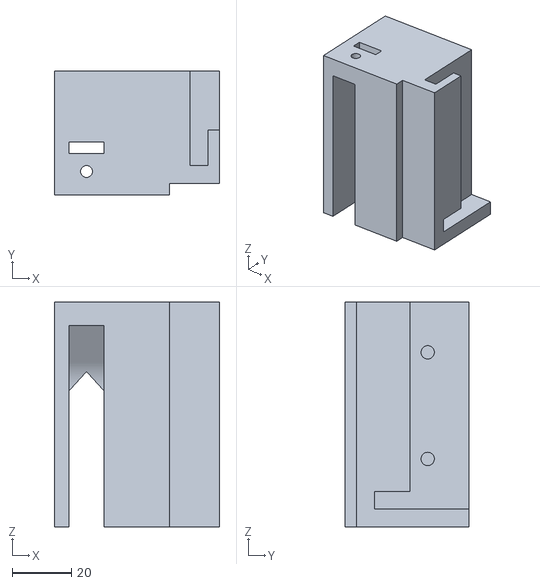
[picture p71: CAD file, 2026-11-10]
arm/stl/balance_mast_l.stl
55.9 x 42.0 x 76.0
