paszkowskiDamian/tendon-torso/arm/stl/balance_sheave.stl

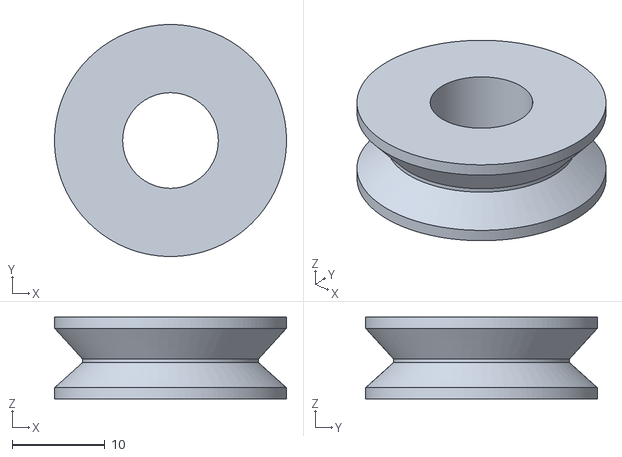
[picture p72: CAD file, 2026-11-10]
arm/stl/balance_sheave.stl
25.0 x 25.0 x 8.80
