paszkowskiDamian/tendon-torso/arm/stl/drive_socket_block_b.stl

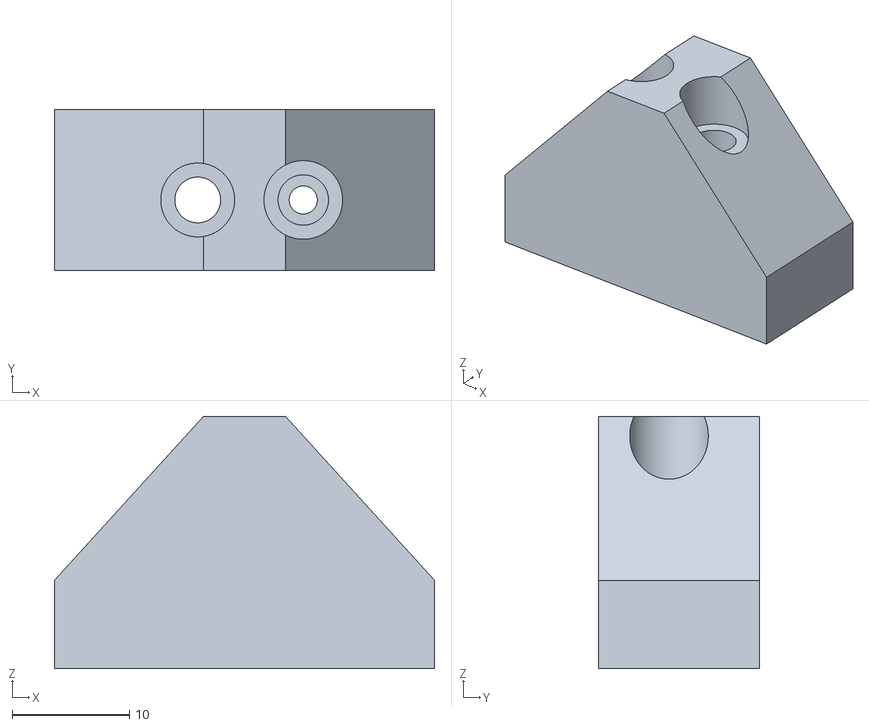
[picture p73: CAD file, 2026-11-10]
arm/stl/drive_socket_block_b.stl
32.4 x 13.7 x 21.5
