paszkowskiDamian/tendon-torso/sim/assets/f_rotor_l.stl

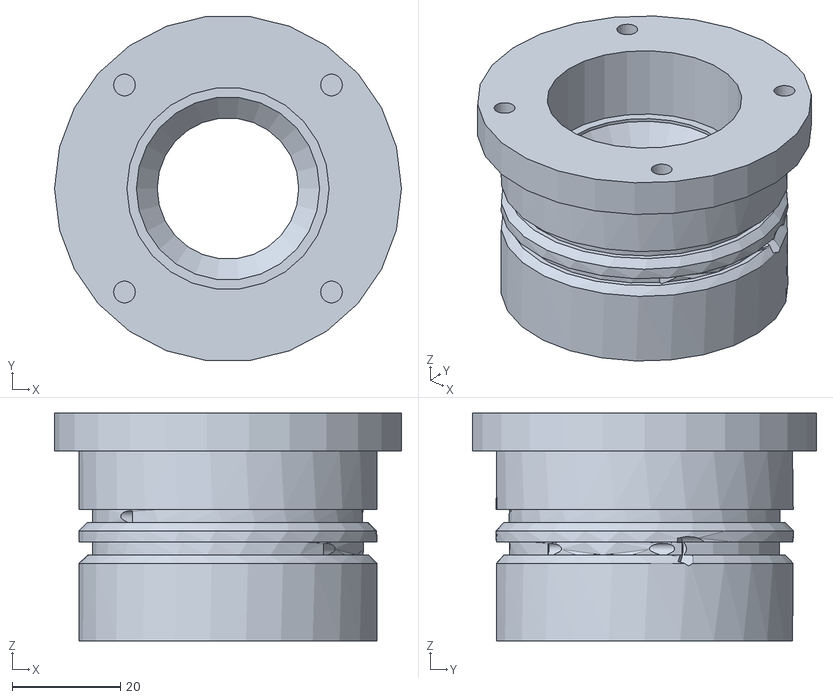
[picture p74: CAD file, 2026-11-11]
sim/assets/f_rotor_l.stl
64.0 x 63.5 x 42.0
