paszkowskiDamian/tendon-torso/arm/stl/drive_tube_clip.stl

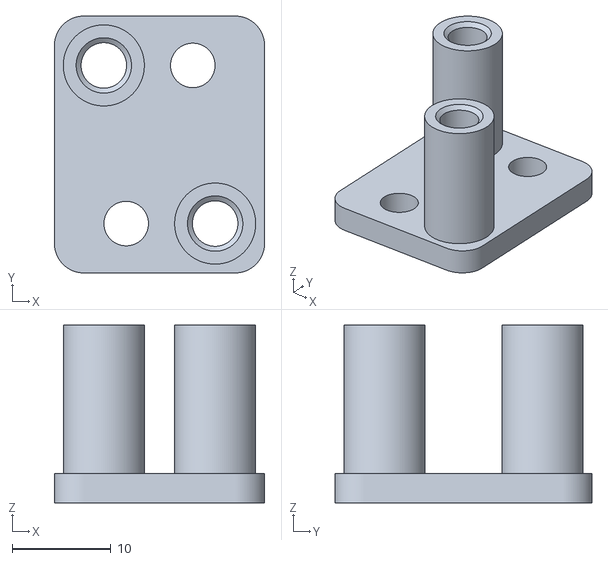
[picture p75: CAD file, 2026-11-10]
arm/stl/drive_tube_clip.stl
21.3 x 26.0 x 18.0
