paszkowskiDamian/tendon-torso/arm/stl/s3_rotor.stl

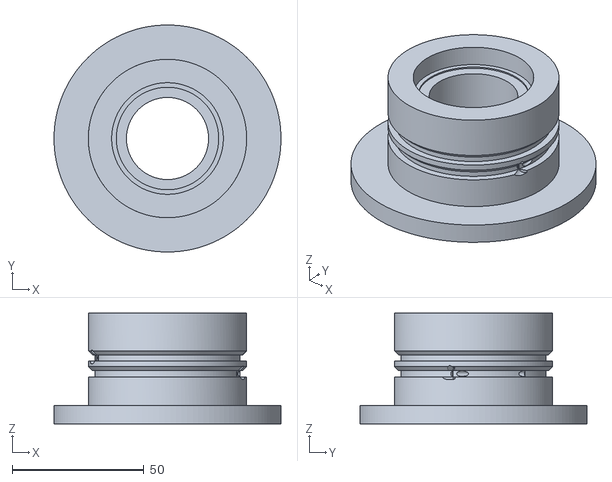
[picture p76: CAD file, 2026-11-10]
arm/stl/s3_rotor.stl
86.0 x 86.0 x 42.0
