paszkowskiDamian/tendon-torso/arm/stl/idler_tyre.stl

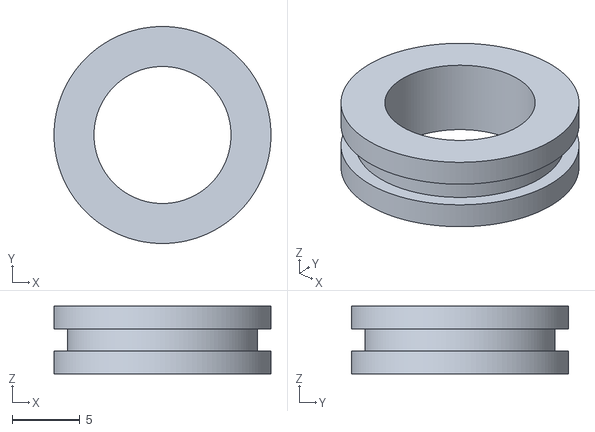
[picture p77: CAD file, 2026-11-10]
arm/stl/idler_tyre.stl
16.0 x 16.0 x 5.00
