paszkowskiDamian/tendon-torso/sim/assets/torso_saddles.stl

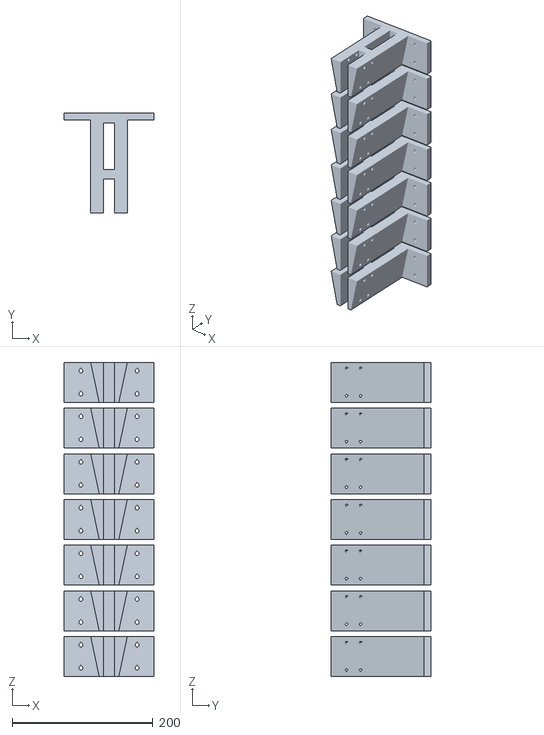
[picture p78: CAD file, 2026-11-11]
sim/assets/torso_saddles.stl
128.0 x 142.0 x 446.7
