paszkowskiDamian/tendon-torso/sim/assets/torso_alu.stl

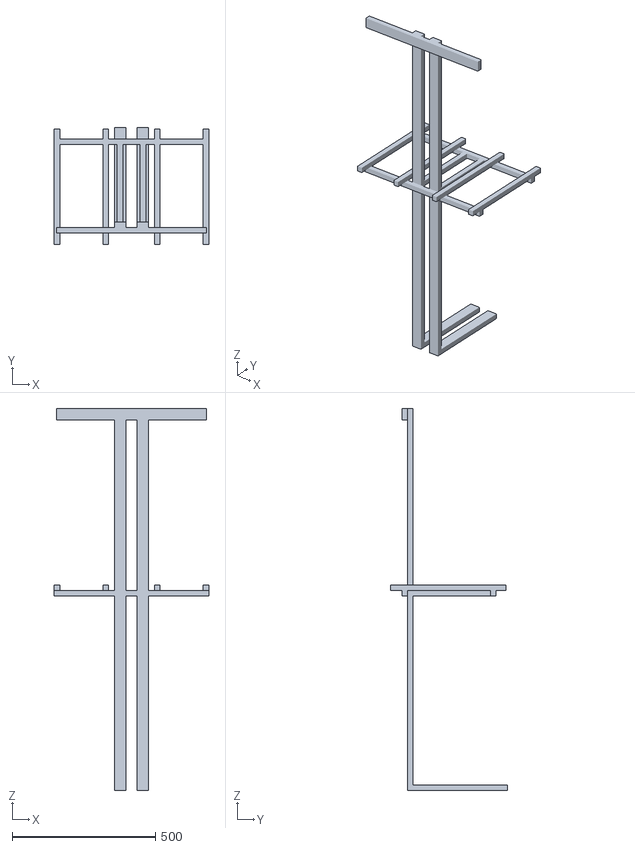
[picture p79: CAD file, 2026-11-11]
sim/assets/torso_alu.stl
540.0 x 410.0 x 1335.0
