paszkowskiDamian/tendon-torso/sim/assets/torso_drives.stl

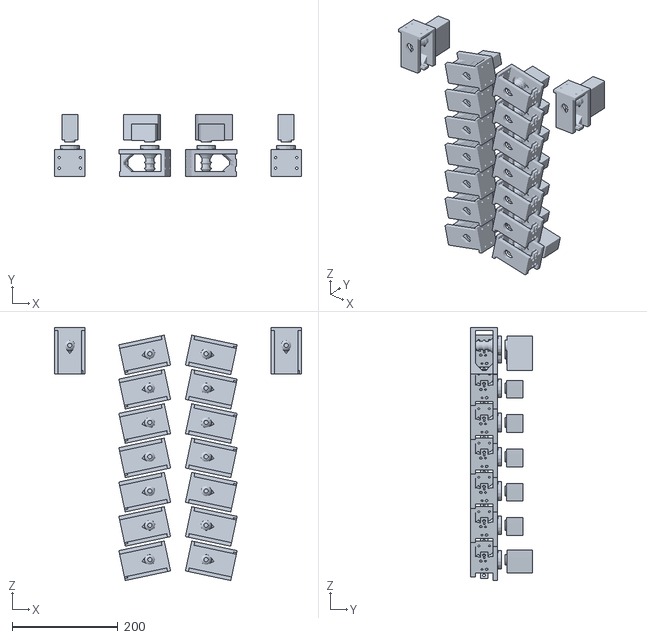
[picture p80: CAD file, 2026-11-11]
sim/assets/torso_drives.stl
468.0 x 117.0 x 479.6
