paszkowskiDamian/tendon-torso/(list of files, cad)

Other CAD files:
joints/j1b-2dof/stl/j1_proximal_through.step
sim/assets/link_forearm_l.stl
arm/stl/drive_adapter_sts3095.stl
sim/assets/gripper_pad_a_l.stl
sim/assets/w2_base_r.stl
sim/assets/f_stator_l.stl
sim/assets/w2_base_l.stl
sim/assets/w1_rotor_b_l.stl
arm/stl/w1_rotor_a.stl
sim/assets/w2_rotor_a_r.stl
arm/stl/w2_rotor_a.stl
arm/stl/e_rotor_b.stl
sim/assets/s3_idler_b_l.stl
arm/stl/s1_rotor_a.stl
sim/assets/s2_rotor_b_r.stl
arm/stl/e_rotor_a.stl
sim/assets/f_idler_a_l.stl
arm/stl/w1_rotor_b.stl
sim/assets/s2_rotor_b_l.stl
arm/stl/s2_rotor_a.stl
sim/assets/s3_idler_b_r.stl
arm/stl/gripper_finger_b.stl
sim/assets/f_idler_b_r.stl
arm/stl/gripper_finger_a.stl
sim/assets/s1_rotor_a_r.stl
arm/stl/gripper_palm.stl
sim/assets/w2_rotor_b_l.stl
arm/stl/s2_base.stl
sim/assets/torso_beam_l.stl
arm/stl/w1_base.stl
sim/assets/link_e_f_l.stl
arm/stl/gripper_pad.stl
sim/assets/s1_rotor_a_l.stl
sim/assets/f_idler_a_r.stl
sim/assets/f_retainer_l.stl
sim/assets/s3_stator_r.stl
sim/assets/w2_rotor_a_l.stl
arm/stl/link_forearm.stl
sim/assets/gripper_pad_a_r.stl
sim/assets/gripper_finger_b_r.stl
sim/assets/w1_rotor_a_r.stl
arm/stl/link_w1_w2.stl
sim/assets/w1_base_r.stl
arm/stl/w2_base.stl
sim/assets/w1_rotor_a_l.stl
sim/assets/s3_idler_a_r.stl
arm/stl/balance_mast_r.stl
sim/assets/e_base_l.stl
sim/assets/e_rotor_b_l.stl
arm/stl/drive_socket_block_a.stl
sim/assets/s1_rotor_b_l.stl
sim/assets/e_rotor_a_r.stl
sim/assets/link_s1_s2_l.stl
sim/assets/e_rotor_a_l.stl
arm/stl/f_retainer.stl
sim/assets/e_base_r.stl
arm/stl/f_rotor.stl
sim/assets/gripper_palm_l.stl
arm/stl/s3_retainer.stl
sim/assets/s3_rotor_r.stl
sim/assets/s1_base_r.stl
sim/assets/link_s1_s2_r.stl
sim/assets/s1_base_l.stl
sim/assets/s2_base_r.stl
sim/assets/link_w1_w2_r.stl
sim/assets/f_rotor_r.stl
sim/assets/link_s2_s3_r.stl
sim/assets/link_upper_r.stl
sim/assets/s3_retainer_r.stl
sim/assets/s1_rotor_b_r.stl
sim/assets/w1_rotor_b_r.stl
sim/assets/gripper_pad_b_l.stl
sim/assets/w2_rotor_b_r.stl
sim/assets/link_s2_s3_l.stl
sim/assets/s2_rotor_a_r.stl
sim/assets/gripper_finger_a_l.stl
sim/assets/torso_beam_r.stl
sim/assets/s3_idler_a_l.stl
arm/stl/drive_nut_cup.stl
joints/j1-hinge/stl/assembly_preview.step
joints/j1-hinge/stl/base.step
joints/j1-hinge/stl/base.stl
joints/j1-hinge/stl/distal_half.step
joints/j1-hinge/stl/distal_half.stl
joints/j1-hinge/stl/proximal.step
joints/j1-hinge/stl/proximal.stl
joints/j1-hinge/stl/spool.step
joints/j1-hinge/stl/spool.stl
joints/j1b-2dof/stl/bowden_drive.stl
joints/j1b-2dof/stl/j1_distal_half_mount.stl
joints/j1b-2dof/stl/j1_proximal_through.stl
joints/j1b-2dof/stl/j2_distal_half.stl
joints/j1b-2dof/stl/j2_mount.stl
joints/j1s-hinge/stl/base.stl
joints/j1s-hinge/stl/distal_half.stl
joints/j1s-hinge/stl/proximal.stl
joints/j1s-hinge/stl/spool.stl
