paszkowskiDamian/tendon-torso/arm/stl/PRINT_LIST.md

| File | Qty | Size (mm) | Notes |
|---|---|---|---|
| `s1_base.stl` | 2 | 99 x 52 x 86 | S1 hinge base - plate down; x2: right arm as exported, left arm mirrored (slicer: mirror X) |
| `s1_rotor_a.stl` | 2 | 52 x 104 x 119 | S1 rotor half A - top plate down; x2: right arm as exported, left arm mirrored (slicer: mirror X) |
| `s1_rotor_b.stl` | 2 | 52 x 104 x 119 | S1 rotor half B - top plate down; x2: right arm as exported, left arm mirrored (slicer: mirror X) |
| `s2_base.stl` | 2 | 104 x 104 x 86 | S2 hinge base - plate down; x2: right arm as exported, left arm mirrored (slicer: mirror X) |
| `s2_rotor_a.stl` | 2 | 52 x 104 x 107 | S2 rotor half A - top plate down; x2: right arm as exported, left arm mirrored (slicer: mirror X) |
| `s2_rotor_b.stl` | 2 | 52 x 104 x 107 | S2 rotor half B - top plate down; x2: right arm as exported, left arm mirrored (slicer: mirror X) |
| `e_base.stl` | 2 | 64 x 64 x 75 | E hinge base - plate down; x2: right arm as exported, left arm mirrored (slicer: mirror X) |
| `e_rotor_a.stl` | 2 | 32 x 76 x 95 | E rotor half A - top plate down; x2: right arm as exported, left arm mirrored (slicer: mirror X) |
| `e_rotor_b.stl` | 2 | 32 x 76 x 95 | E rotor half B - top plate down; x2: right arm as exported, left arm mirrored (slicer: mirror X) |
| `w1_base.stl` | 2 | 64 x 64 x 57 | W1 hinge base - plate down; x2: right arm as exported, left arm mirrored (slicer: mirror X) |
| `w1_rotor_a.stl` | 2 | 32 x 64 x 63 | W1 rotor half A - top plate down; x2: right arm as exported, left arm mirrored (slicer: mirror X) |
| `w1_rotor_b.stl` | 2 | 32 x 64 x 63 | W1 rotor half B - top plate down; x2: right arm as exported, left arm mirrored (slicer: mirror X) |
| `w2_base.stl` | 2 | 64 x 64 x 57 | W2 hinge base - plate down; x2: right arm as exported, left arm mirrored (slicer: mirror X) |
| `w2_rotor_a.stl` | 2 | 32 x 64 x 63 | W2 rotor half A - top plate down; x2: right arm as exported, left arm mirrored (slicer: mirror X) |
| `w2_rotor_b.stl` | 2 | 32 x 64 x 63 | W2 rotor half B - top plate down; x2: right arm as exported, left arm mirrored (slicer: mirror X) |
| `s3_stator.stl` | 2 | 104 x 104 x 43 | S3 roll stator - plate down; x2: right arm as exported, left arm mirrored (slicer: mirror X) |
| `s3_rotor.stl` | 2 | 86 x 86 x 42 | S3 roll rotor - top plate down; x2: right arm as exported, left arm mirrored (slicer: mirror X) |
| `s3_retainer.stl` | 2 | 32 x 32 x 3 | S3 bearing retainer; x2: right arm as exported, left arm mirrored (slicer: mirror X) |
| `f_stator.stl` | 2 | 100 x 100 x 43 | F roll stator - plate down; x2: right arm as exported, left arm mirrored (slicer: mirror X) |
| `f_rotor.stl` | 2 | 64 x 64 x 42 | F roll rotor - top plate down; x2: right arm as exported, left arm mirrored (slicer: mirror X) |
| `f_retainer.stl` | 2 | 27 x 27 x 3 | F bearing retainer; x2: right arm as exported, left arm mirrored (slicer: mirror X) |
| `idler_tyre.stl` | 8 | 16 x 16 x 5 | idler tyre for a 623 bearing (2 per roll joint); x2: right arm as exported, left arm mirrored (slicer: mirror X) |
| `link_s1_s2.stl` | 2 | 184 x 104 x 22 | link L->L, 22 mm + balance yoke arms - bottom lip down, arms flat on the bed; x2: right arm as exported, left arm mirrored (slicer: mirror X) |
| `link_s2_s3.stl` | 2 | 104 x 104 x 60 | link L->L, 60 mm - bottom lip down, 48 deg cone under the top lip; x2: right arm as exported, left arm mirrored (slicer: mirror X) |
| `link_upper.stl` | 2 | 86 x 86 x 64 | link M->S, 64 mm - bottom lip down, 48 deg cone under the top lip; x2: right arm as exported, left arm mirrored (slicer: mirror X) |
| `link_e_f.stl` | 2 | 100 x 100 x 55 | link S->ML, 55 mm - bottom lip down, 48 deg cone under the top lip; x2: right arm as exported, left arm mirrored (slicer: mirror X) |
| `link_forearm.stl` | 2 | 64 x 64 x 41 | link S->S, 41 mm - bottom lip down, 48 deg cone under the top lip; x2: right arm as exported, left arm mirrored (slicer: mirror X) |
| `link_w1_w2.stl` | 2 | 64 x 64 x 22 | link S->S, 22 mm - bottom lip down, 48 deg cone under the top lip; x2: right arm as exported, left arm mirrored (slicer: mirror X) |
| `fitting_cord_thimble.stl` | 8 | 15 x 24 x 5 | cord thimble (cord to spring hook / eye) - flat |
| `balance_mast_r.stl` | 2 | 56 x 42 x 76 | balance pulley mast, +X side - front face down (tent roof over the cord slot) (x2: one set per arm) |
| `balance_mast_l.stl` | 2 | 56 x 42 x 76 | balance pulley mast, -X side (mirror) - front face down (x2: one set per arm) |
| `balance_sheave.stl` | 4 | 25 x 25 x 9 | balance sheave on 2x 623 - flat (48 deg groove ceiling) (x2: one set per arm) |
| `balance_post.stl` | 4 | 40 x 72 x 66 | balance spring anchor post - foot down (M5 hole is a teardrop) (x2: one set per arm) |
| `gripper_palm.stl` | 2 | 62 x 62 x 37 | gripper palm (4x M3x10 into W2, 2x M3x25 finger pivots, Bowden socket) - plate down; x2: right arm as exported, left arm mirrored (slicer: mirror X) |
| `gripper_finger_a.stl` | 2 | 34 x 74 x 14 | gripper finger A (cord drum + gear) - gear side down; x2: right arm as exported, left arm mirrored (slicer: mirror X) |
| `gripper_finger_b.stl` | 2 | 34 x 73 x 14 | gripper finger B (gear) - gear side down; x2: right arm as exported, left arm mirrored (slicer: mirror X) |
| `gripper_pad.stl` | 4 | 11 x 18 x 34 | gripper pad sleeve (TPU 95A or PETG), 1x M3x6 each - open end down; x2: right arm as exported, left arm mirrored (slicer: mirror X) |
| `drive_socket_block_a.stl` | 16 | 32 x 14 x 22 | socket / tension block for cord A (1 M4x45 + nut) - nut trap down |
| `drive_socket_block_b.stl` | 14 | 32 x 14 x 22 | socket / tension block for cord B (1 M4x45 + nut), not on the gripper units - nut trap down |
| `drive_tube_clip.stl` | 16 | 21 x 26 x 18 | tube clip on the drive frame top, under both tension screw heads - plate down |
| `drive_nut_cup.stl` | 16 | 24 x 24 x 13 | M8 nut cup (wall A side of the spool shaft) - nut pocket down |
| `drive_frame.stl` | 16 | 51 x 58 x 88 | drive unit frame - foot down (teardrop bearing pockets, 48 deg roof) |
| `drive_spool.stl` | 16 | 36 x 36 x 50 | drive spool hub (crank helices + 6805 journal + pin flange) - standing on its -X boss, 0.12 mm layers, brim |
| `drive_adapter_sts3215.stl` | 8 | 36 x 36 x 6 | horn adapter for STS3215 - motor face down; x8 (phase 1: F, W1, W2, G on both arms) |
| `drive_cup_sts3215.stl` | 8 | 67 x 55 x 52 | motor cup for STS3215 - end plate down; x8 (phase 1: F, W1, W2, G on both arms) |
| `drive_adapter_sts3250.stl` | 4 | 36 x 36 x 6 | horn adapter for STS3250 - motor face down; x4 (phase 1: S3, E on both arms) |
| `drive_cup_sts3250.stl` | 4 | 67 x 55 x 52 | motor cup for STS3250 - end plate down; x4 (phase 1: S3, E on both arms) |
| `drive_adapter_sts3095.stl` | 4 | 36 x 36 x 6 | horn adapter for STS3095 - motor face down; x4 (phase 1: S1, S2 on both arms) |
| `drive_cup_sts3095.stl` | 4 | 82 x 55 x 70 | motor cup for STS3095 - end plate down; x4 (phase 1: S1, S2 on both arms) |
| `drive_adapter_dmj4310.stl` | 0 | 57 x 57 x 6 | horn adapter for DM-J4310 - motor face down; upgrade path, print as needed |
| `drive_cup_dmj4310.stl` | 0 | 62 x 62 x 64 | motor cup for DM-J4310 - end plate down; upgrade path, print as needed |
| `torso_shoulder_beam.stl` | 2 | 190 x 140 x 52 | shoulder beam, one per arm (symmetric) - floor down, 6 walls |
| `torso_shoulder_comb.stl` | 2 | 78 x 20 x 30 | shoulder tube comb, 5 x 3 grid above the S1 opening - plate down |
| `torso_s1_hanger.stl` | 2 | 68 x 142 x 63 | S1 drive hanger under the clavicle (symmetric: same part both sides) - plate down |
| `torso_saddle.stl` | 7 | 128 x 142 x 57 | drive saddle, one per level (a right and a left drive unit) - bottom down |
| `torso_electronics_tray.stl` | 1 | 150 x 220 x 12 | electronics tray on the back of the spine - flat, ribs up |
| `torso_estop_box.stl` | 1 | 56 x 60 x 60 | E-stop box (22 mm mushroom) - top down |
