paszkowskiDamian/tendon-torso/sim/robot.xml

<!-- generated by sim/build_model.py from the CAD in arm/ - do not edit by hand -->
<mujoco model="tendon-torso">
  <compiler angle="radian" meshdir="assets" autolimits="true"/>
  <option timestep="0.002" integrator="implicitfast" cone="elliptic" impratio="10"/>
  <size memory="64M"/>
  <default>
    <mesh scale="0.001 0.001 0.001"/>
    <joint damping="0.3" armature="0.01" frictionloss="0.02"/>
    <default class="hinge"><joint damping="1.0" armature="0.05"/></default>
    <default class="roll"><joint damping="0.5" armature="0.02"/></default>
    <default class="finger"><joint damping="0.02" armature="0.001" frictionloss="0.002"/></default>
    <default class="visual"><geom type="mesh" contype="0" conaffinity="0" group="2" density="0"/></default>
    <default class="hull"><geom type="mesh" contype="2" conaffinity="0" group="3" density="0" rgba="1 1 1 0.2"/></default>
    <default class="pad"><geom contype="1" conaffinity="1" group="3" density="0" friction="1.2 0.02 0.001" condim="4" solref="0.004 1" solimp="0.95 0.99 0.001" rgba="0.1 0.1 0.1 0.4"/></default>
  </default>
  <asset>
    <mesh name="s1_base_r" file="s1_base_r.stl"/>
    <mesh name="s1_base_l" file="s1_base_l.stl"/>
    <mesh name="s1_rotor_a_r" file="s1_rotor_a_r.stl"/>
    <mesh name="s1_rotor_a_l" file="s1_rotor_a_l.stl"/>
    <mesh name="s1_rotor_b_r" file="s1_rotor_b_r.stl"/>
    <mesh name="s1_rotor_b_l" file="s1_rotor_b_l.stl"/>
    <mesh name="link_s1_s2_r" file="link_s1_s2_r.stl"/>
    <mesh name="link_s1_s2_l" file="link_s1_s2_l.stl"/>
    <mesh name="s2_base_r" file="s2_base_r.stl"/>
    <mesh name="s2_base_l" file="s2_base_l.stl"/>
    <mesh name="s2_rotor_a_r" file="s2_rotor_a_r.stl"/>
    <mesh name="s2_rotor_a_l" file="s2_rotor_a_l.stl"/>
    <mesh name="s2_rotor_b_r" file="s2_rotor_b_r.stl"/>
    <mesh name="s2_rotor_b_l" file="s2_rotor_b_l.stl"/>
    <mesh name="link_s2_s3_r" file="link_s2_s3_r.stl"/>
    <mesh name="link_s2_s3_l" file="link_s2_s3_l.stl"/>
    <mesh name="s3_stator_r" file="s3_stator_r.stl"/>
    <mesh name="s3_stator_l" file="s3_stator_l.stl"/>
    <mesh name="s3_retainer_r" file="s3_retainer_r.stl"/>
    <mesh name="s3_retainer_l" file="s3_retainer_l.stl"/>
    <mesh name="s3_idler_a_r" file="s3_idler_a_r.stl"/>
    <mesh name="s3_idler_a_l" file="s3_idler_a_l.stl"/>
    <mesh name="s3_idler_b_r" file="s3_idler_b_r.stl"/>
    <mesh name="s3_idler_b_l" file="s3_idler_b_l.stl"/>
    <mesh name="s3_rotor_r" file="s3_rotor_r.stl"/>
    <mesh name="s3_rotor_l" file="s3_rotor_l.stl"/>
    <mesh name="link_upper_r" file="link_upper_r.stl"/>
    <mesh name="link_upper_l" file="link_upper_l.stl"/>
    <mesh name="e_base_r" file="e_base_r.stl"/>
    <mesh name="e_base_l" file="e_base_l.stl"/>
    <mesh name="e_rotor_a_r" file="e_rotor_a_r.stl"/>
    <mesh name="e_rotor_a_l" file="e_rotor_a_l.stl"/>
    <mesh name="e_rotor_b_r" file="e_rotor_b_r.stl"/>
    <mesh name="e_rotor_b_l" file="e_rotor_b_l.stl"/>
    <mesh name="link_e_f_r" file="link_e_f_r.stl"/>
    <mesh name="link_e_f_l" file="link_e_f_l.stl"/>
    <mesh name="f_stator_r" file="f_stator_r.stl"/>
    <mesh name="f_stator_l" file="f_stator_l.stl"/>
    <mesh name="f_retainer_r" file="f_retainer_r.stl"/>
    <mesh name="f_retainer_l" file="f_retainer_l.stl"/>
    <mesh name="f_idler_a_r" file="f_idler_a_r.stl"/>
    <mesh name="f_idler_a_l" file="f_idler_a_l.stl"/>
    <mesh name="f_idler_b_r" file="f_idler_b_r.stl"/>
    <mesh name="f_idler_b_l" file="f_idler_b_l.stl"/>
    <mesh name="f_rotor_r" file="f_rotor_r.stl"/>
    <mesh name="f_rotor_l" file="f_rotor_l.stl"/>
    <mesh name="link_forearm_r" file="link_forearm_r.stl"/>
    <mesh name="link_forearm_l" file="link_forearm_l.stl"/>
    <mesh name="w1_base_r" file="w1_base_r.stl"/>
    <mesh name="w1_base_l" file="w1_base_l.stl"/>
    <mesh name="w1_rotor_a_r" file="w1_rotor_a_r.stl"/>
    <mesh name="w1_rotor_a_l" file="w1_rotor_a_l.stl"/>
    <mesh name="w1_rotor_b_r" file="w1_rotor_b_r.stl"/>
    <mesh name="w1_rotor_b_l" file="w1_rotor_b_l.stl"/>
    <mesh name="link_w1_w2_r" file="link_w1_w2_r.stl"/>
    <mesh name="link_w1_w2_l" file="link_w1_w2_l.stl"/>
    <mesh name="w2_base_r" file="w2_base_r.stl"/>
    <mesh name="w2_base_l" file="w2_base_l.stl"/>
    <mesh name="w2_rotor_a_r" file="w2_rotor_a_r.stl"/>
    <mesh name="w2_rotor_a_l" file="w2_rotor_a_l.stl"/>
    <mesh name="w2_rotor_b_r" file="w2_rotor_b_r.stl"/>
    <mesh name="w2_rotor_b_l" file="w2_rotor_b_l.stl"/>
    <mesh name="gripper_palm_r" file="gripper_palm_r.stl"/>
    <mesh name="gripper_palm_l" file="gripper_palm_l.stl"/>
    <mesh name="gripper_finger_a_r" file="gripper_finger_a_r.stl"/>
    <mesh name="gripper_finger_a_l" file="gripper_finger_a_l.stl"/>
    <mesh name="gripper_pad_a_r" file="gripper_pad_a_r.stl"/>
    <mesh name="gripper_pad_a_l" file="gripper_pad_a_l.stl"/>
    <mesh name="gripper_finger_b_r" file="gripper_finger_b_r.stl"/>
    <mesh name="gripper_finger_b_l" file="gripper_finger_b_l.stl"/>
    <mesh name="gripper_pad_b_r" file="gripper_pad_b_r.stl"/>
    <mesh name="gripper_pad_b_l" file="gripper_pad_b_l.stl"/>
    <mesh name="torso_alu" file="torso_alu.stl"/>
    <mesh name="torso_beam_r" file="torso_beam_r.stl"/>
    <mesh name="torso_beam_l" file="torso_beam_l.stl"/>
    <mesh name="torso_saddles" file="torso_saddles.stl"/>
    <mesh name="torso_drives" file="torso_drives.stl"/>
  </asset>
  <worldbody>
    <body name="torso">
    <geom class="visual" mesh="torso_alu" rgba="0.62 0.64 0.68 1"/>
    <geom class="visual" mesh="torso_beam_r" rgba="0.62 0.64 0.68 1"/>
    <geom class="visual" mesh="torso_beam_l" rgba="0.62 0.64 0.68 1"/>
    <geom class="visual" mesh="torso_saddles" rgba="0.62 0.64 0.68 1"/>
    <geom class="visual" mesh="torso_drives" rgba="0.25 0.27 0.30 1"/>
    </body>
    <body gravcomp="1" name="r_base" pos="-0.175 0 0.719" quat="6.12323e-17 0 1 0">
      <geom class="visual" mesh="s1_base_r" pos="0 0 0.069" quat="1 0 0 0" rgba="0.85 0.45 0.20 1"/>
      <geom class="hull" mesh="s1_base_r" pos="0 0 0.069" quat="1 0 0 0"/>
      <inertial pos="1.96788e-14 2.10873e-16 0.0310886" mass="0.15158" diaginertia="6.25137e-05 0.000106686 7.76448e-05"/>
      <body gravcomp="1" name="r_S1" pos="0 0 0.069" quat="1 0 0 0">
        <joint name="r_S1" class="hinge" axis="1 0 0" range="-0.52360 2.09440"/>
        <geom class="visual" mesh="s1_rotor_a_r" pos="0 0 0" quat="1 0 0 0" rgba="0.30 0.55 0.85 1"/>
        <geom class="hull" mesh="s1_rotor_a_r" pos="0 0 0" quat="1 0 0 0"/>
        <geom class="visual" mesh="s1_rotor_b_r" pos="0 0 0" quat="1 0 0 0" rgba="0.30 0.55 0.85 1"/>
        <geom class="hull" mesh="s1_rotor_b_r" pos="0 0 0" quat="1 0 0 0"/>
        <geom class="visual" mesh="link_s1_s2_r" pos="0 0 0.075" quat="1 0 0 0" rgba="0.80 0.80 0.82 1"/>
        <geom class="hull" mesh="link_s1_s2_r" pos="0 0 0.075" quat="1 0 0 0"/>
        <geom class="visual" mesh="s2_base_r" pos="0 0 0.166" quat="0.707107 0 0 0.707107" rgba="0.85 0.45 0.20 1"/>
        <geom class="hull" mesh="s2_base_r" pos="0 0 0.166" quat="0.707107 0 0 0.707107"/>
        <inertial pos="5.36598e-08 0.000723817 0.0793285" mass="0.38244" diaginertia="0.000971387 0.000975466 0.000340425"/>
        <body gravcomp="1" name="r_S2" pos="0 0 0.166" quat="0.707107 0 0 0.707107">
          <joint name="r_S2" class="hinge" axis="1 0 0" range="-0.17453 1.74533"/>
          <geom class="visual" mesh="s2_rotor_a_r" pos="0 0 0" quat="1 0 0 0" rgba="0.30 0.55 0.85 1"/>
          <geom class="hull" mesh="s2_rotor_a_r" pos="0 0 0" quat="1 0 0 0"/>
          <geom class="visual" mesh="s2_rotor_b_r" pos="0 0 0" quat="1 0 0 0" rgba="0.30 0.55 0.85 1"/>
          <geom class="hull" mesh="s2_rotor_b_r" pos="0 0 0" quat="1 0 0 0"/>
          <geom class="visual" mesh="link_s2_s3_r" pos="0 0 0.063" quat="1 0 0 0" rgba="0.80 0.80 0.82 1"/>
          <geom class="hull" mesh="link_s2_s3_r" pos="0 0 0.063" quat="1 0 0 0"/>
          <geom class="visual" mesh="s3_stator_r" pos="0 0 0.13" quat="1 0 0 0" rgba="0.85 0.45 0.20 1"/>
          <geom class="hull" mesh="s3_stator_r" pos="0 0 0.13" quat="1 0 0 0"/>
          <geom class="visual" mesh="s3_retainer_r" pos="0 0 0.13" quat="1 0 0 0" rgba="0.55 0.55 0.6 1"/>
          <geom class="hull" mesh="s3_retainer_r" pos="0 0 0.13" quat="1 0 0 0"/>
          <geom class="visual" mesh="s3_idler_a_r" pos="0 0 0.13" quat="1 0 0 0" rgba="0.25 0.25 0.25 1"/>
          <geom class="hull" mesh="s3_idler_a_r" pos="0 0 0.13" quat="1 0 0 0"/>
          <geom class="visual" mesh="s3_idler_b_r" pos="0 0 0.13" quat="1 0 0 0" rgba="0.25 0.25 0.25 1"/>
          <geom class="hull" mesh="s3_idler_b_r" pos="0 0 0.13" quat="1 0 0 0"/>
          <inertial pos="-2.92859e-05 0.000813 0.0716414" mass="0.32309" diaginertia="0.000858336 0.000809362 0.000234358"/>
          <body gravcomp="1" name="r_S3" pos="0 0 0.13" quat="1 0 0 0">
            <joint name="r_S3" class="roll" axis="0 0 1" range="-1.39626 1.39626"/>
            <geom class="visual" mesh="s3_rotor_r" pos="0 0 0" quat="1 0 0 0" rgba="0.30 0.55 0.85 1"/>
            <geom class="hull" mesh="s3_rotor_r" pos="0 0 0" quat="1 0 0 0"/>
            <geom class="visual" mesh="link_upper_r" pos="0 0 0.043" quat="1 0 0 0" rgba="0.80 0.80 0.82 1"/>
            <geom class="hull" mesh="link_upper_r" pos="0 0 0.043" quat="1 0 0 0"/>
            <geom class="visual" mesh="e_base_r" pos="0 0 0.17" quat="0.707107 0 0 0.707107" rgba="0.85 0.45 0.20 1"/>
            <geom class="hull" mesh="e_base_r" pos="0 0 0.17" quat="0.707107 0 0 0.707107"/>
            <inertial pos="2.49818e-09 2.88352e-06 0.0723249" mass="0.20334" diaginertia="0.000539678 0.000540431 0.000102885"/>
            <body gravcomp="1" name="r_E" pos="0 0 0.17" quat="0.707107 0 0 0.707107">
              <joint name="r_E" class="hinge" axis="1 0 0" range="0.00000 2.00713"/>
              <geom class="visual" mesh="e_rotor_a_r" pos="0 0 0" quat="1 0 0 0" rgba="0.30 0.55 0.85 1"/>
              <geom class="hull" mesh="e_rotor_a_r" pos="0 0 0" quat="1 0 0 0"/>
              <geom class="visual" mesh="e_rotor_b_r" pos="0 0 0" quat="1 0 0 0" rgba="0.30 0.55 0.85 1"/>
              <geom class="hull" mesh="e_rotor_b_r" pos="0 0 0" quat="1 0 0 0"/>
              <geom class="visual" mesh="link_e_f_r" pos="0 0 0.057" quat="1 0 0 0" rgba="0.80 0.80 0.82 1"/>
              <geom class="hull" mesh="link_e_f_r" pos="0 0 0.057" quat="1 0 0 0"/>
              <geom class="visual" mesh="f_stator_r" pos="0 0 0.119" quat="1 0 0 0" rgba="0.85 0.45 0.20 1"/>
              <geom class="hull" mesh="f_stator_r" pos="0 0 0.119" quat="1 0 0 0"/>
              <geom class="visual" mesh="f_retainer_r" pos="0 0 0.119" quat="1 0 0 0" rgba="0.55 0.55 0.6 1"/>
              <geom class="hull" mesh="f_retainer_r" pos="0 0 0.119" quat="1 0 0 0"/>
              <geom class="visual" mesh="f_idler_a_r" pos="0 0 0.119" quat="1 0 0 0" rgba="0.25 0.25 0.25 1"/>
              <geom class="hull" mesh="f_idler_a_r" pos="0 0 0.119" quat="1 0 0 0"/>
              <geom class="visual" mesh="f_idler_b_r" pos="0 0 0.119" quat="1 0 0 0" rgba="0.25 0.25 0.25 1"/>
              <geom class="hull" mesh="f_idler_b_r" pos="0 0 0.119" quat="1 0 0 0"/>
              <inertial pos="-3.95009e-05 0.000884428 0.0739051" mass="0.22164" diaginertia="0.000502203 0.000487643 0.000137574"/>
              <body gravcomp="1" name="r_F" pos="0 0 0.119" quat="1 0 0 0">
                <joint name="r_F" class="roll" axis="0 0 1" range="-1.48353 1.48353"/>
                <geom class="visual" mesh="f_rotor_r" pos="0 0 0" quat="1 0 0 0" rgba="0.30 0.55 0.85 1"/>
                <geom class="hull" mesh="f_rotor_r" pos="0 0 0" quat="1 0 0 0"/>
                <geom class="visual" mesh="link_forearm_r" pos="0 0 0.043" quat="1 0 0 0" rgba="0.80 0.80 0.82 1"/>
                <geom class="hull" mesh="link_forearm_r" pos="0 0 0.043" quat="1 0 0 0"/>
                <geom class="visual" mesh="w1_base_r" pos="0 0 0.131" quat="1 0 0 0" rgba="0.85 0.45 0.20 1"/>
                <geom class="hull" mesh="w1_base_r" pos="0 0 0.131" quat="1 0 0 0"/>
                <inertial pos="-1.74505e-09 3.45649e-06 0.0592679" mass="0.13717" diaginertia="0.000202848 0.000203181 4.555e-05"/>
                <body gravcomp="1" name="r_W1" pos="0 0 0.131" quat="1 0 0 0">
                  <joint name="r_W1" class="hinge" axis="1 0 0" range="-1.04720 1.04720"/>
                  <geom class="visual" mesh="w1_rotor_a_r" pos="0 0 0" quat="1 0 0 0" rgba="0.30 0.55 0.85 1"/>
                  <geom class="hull" mesh="w1_rotor_a_r" pos="0 0 0" quat="1 0 0 0"/>
                  <geom class="visual" mesh="w1_rotor_b_r" pos="0 0 0" quat="1 0 0 0" rgba="0.30 0.55 0.85 1"/>
                  <geom class="hull" mesh="w1_rotor_b_r" pos="0 0 0" quat="1 0 0 0"/>
                  <geom class="visual" mesh="link_w1_w2_r" pos="0 0 0.041" quat="1 0 0 0" rgba="0.80 0.80 0.82 1"/>
                  <geom class="hull" mesh="link_w1_w2_r" pos="0 0 0.041" quat="1 0 0 0"/>
                  <geom class="visual" mesh="w2_base_r" pos="0 0 0.11" quat="0.707107 0 0 0.707107" rgba="0.85 0.45 0.20 1"/>
                  <geom class="hull" mesh="w2_base_r" pos="0 0 0.11" quat="0.707107 0 0 0.707107"/>
                  <inertial pos="7.39964e-10 2.21964e-09 0.050337" mass="0.11592" diaginertia="0.00011502 0.000109365 3.29e-05"/>
                  <body gravcomp="1" name="r_W2" pos="0 0 0.11" quat="0.707107 0 0 0.707107">
                    <joint name="r_W2" class="hinge" axis="1 0 0" range="-1.57080 1.57080"/>
                    <geom class="visual" mesh="w2_rotor_a_r" pos="0 0 0" quat="1 0 0 0" rgba="0.30 0.55 0.85 1"/>
                    <geom class="hull" mesh="w2_rotor_a_r" pos="0 0 0" quat="1 0 0 0"/>
                    <geom class="visual" mesh="w2_rotor_b_r" pos="0 0 0" quat="1 0 0 0" rgba="0.30 0.55 0.85 1"/>
                    <geom class="hull" mesh="w2_rotor_b_r" pos="0 0 0" quat="1 0 0 0"/>
                    <geom class="visual" mesh="gripper_palm_r" pos="0 0 0.041" quat="1 0 0 0" rgba="0.35 0.75 0.45 1"/>
                    <geom class="hull" mesh="gripper_palm_r" pos="0 0 0.041" quat="1 0 0 0"/>
                    <inertial pos="-0.000107402 -0.000264226 0.0724738" mass="0.05087" diaginertia="1.08287e-05 1.08287e-05 1.59699e-05"/>
                    <site name="r_tool" pos="0 0 0.113" quat="1 0 0 0" size="0.006" rgba="1 0.2 0.2 0.6" group="3"/>
                    <camera name="r_wrist" pos="0 -0.048 0.059" xyaxes="-1 0 0 0 0.896268 -0.443514" fovy="80"/>
                    <body gravcomp="1" name="r_finger_a" pos="-0.02 0 0.071" quat="1 0 0 0">
                      <joint name="r_finger_a" class="finger" axis="0 -1 0" range="0 0.71558"/>
                      <geom class="visual" mesh="gripper_finger_a_r" pos="0.02 0 -0.03" quat="1 0 0 0" rgba="0.35 0.75 0.45 1"/>
                      <geom class="visual" mesh="gripper_pad_a_r" pos="0.02 0 -0.03" quat="1 0 0 0" rgba="0.15 0.15 0.15 1"/>
                      <geom name="r_pad_a" class="pad" type="box" size="0.00545 0.00875 0.016875" pos="0.0142 0 0.040875" quat="1 0 0 0"/>
                      <inertial pos="0.02 0 0.03" mass="0.015" diaginertia="4e-6 4e-6 1e-6"/>
                    </body>
                    <body gravcomp="1" name="r_finger_b" pos="0.02 0 0.071" quat="1 0 0 0">
                      <joint name="r_finger_b" class="finger" axis="0 1 0" range="0 0.71558"/>
                      <geom class="visual" mesh="gripper_finger_b_r" pos="-0.02 0 -0.03" quat="1 0 0 0" rgba="0.35 0.75 0.45 1"/>
                      <geom class="visual" mesh="gripper_pad_b_r" pos="-0.02 0 -0.03" quat="1 0 0 0" rgba="0.15 0.15 0.15 1"/>
                      <geom name="r_pad_b" class="pad" type="box" size="0.00545 0.00875 0.016875" pos="-0.0142 0 0.040875" quat="1 0 0 0"/>
                      <inertial pos="-0.02 0 0.03" mass="0.015" diaginertia="4e-6 4e-6 1e-6"/>
                    </body>
                  </body>
                </body>
              </body>
            </body>
          </body>
        </body>
      </body>
      </body>
    <body gravcomp="1" name="l_base" pos="0.175 0 0.719" quat="-6.12323e-17 0 1 0">
      <geom class="visual" mesh="s1_base_l" pos="0 0 0.069" quat="1 0 0 0" rgba="0.85 0.45 0.20 1"/>
      <geom class="hull" mesh="s1_base_l" pos="0 0 0.069" quat="1 0 0 0"/>
      <inertial pos="1.96788e-14 2.10873e-16 0.0310886" mass="0.15158" diaginertia="6.25137e-05 0.000106686 7.76448e-05"/>
      <body gravcomp="1" name="l_S1" pos="0 0 0.069" quat="1 0 0 0">
        <joint name="l_S1" class="hinge" axis="1 -0 -0" range="-0.52360 2.09440"/>
        <geom class="visual" mesh="s1_rotor_a_l" pos="0 0 0" quat="1 0 0 0" rgba="0.30 0.55 0.85 1"/>
        <geom class="hull" mesh="s1_rotor_a_l" pos="0 0 0" quat="1 0 0 0"/>
        <geom class="visual" mesh="s1_rotor_b_l" pos="0 0 0" quat="1 0 0 0" rgba="0.30 0.55 0.85 1"/>
        <geom class="hull" mesh="s1_rotor_b_l" pos="0 0 0" quat="1 0 0 0"/>
        <geom class="visual" mesh="link_s1_s2_l" pos="0 0 0.075" quat="1 0 0 0" rgba="0.80 0.80 0.82 1"/>
        <geom class="hull" mesh="link_s1_s2_l" pos="0 0 0.075" quat="1 0 0 0"/>
        <geom class="visual" mesh="s2_base_l" pos="0 0 0.166" quat="0.707107 0 0 -0.707107" rgba="0.85 0.45 0.20 1"/>
        <geom class="hull" mesh="s2_base_l" pos="0 0 0.166" quat="0.707107 0 0 -0.707107"/>
        <inertial pos="5.36598e-08 0.000723817 0.0793285" mass="0.38244" diaginertia="0.000971387 0.000975466 0.000340425"/>
        <body gravcomp="1" name="l_S2" pos="0 0 0.166" quat="0.707107 0 0 -0.707107">
          <joint name="l_S2" class="hinge" axis="1 -0 -0" range="-0.17453 1.74533"/>
          <geom class="visual" mesh="s2_rotor_a_l" pos="0 0 0" quat="1 0 0 0" rgba="0.30 0.55 0.85 1"/>
          <geom class="hull" mesh="s2_rotor_a_l" pos="0 0 0" quat="1 0 0 0"/>
          <geom class="visual" mesh="s2_rotor_b_l" pos="0 0 0" quat="1 0 0 0" rgba="0.30 0.55 0.85 1"/>
          <geom class="hull" mesh="s2_rotor_b_l" pos="0 0 0" quat="1 0 0 0"/>
          <geom class="visual" mesh="link_s2_s3_l" pos="0 0 0.063" quat="1 0 0 0" rgba="0.80 0.80 0.82 1"/>
          <geom class="hull" mesh="link_s2_s3_l" pos="0 0 0.063" quat="1 0 0 0"/>
          <geom class="visual" mesh="s3_stator_l" pos="0 0 0.13" quat="1 0 0 0" rgba="0.85 0.45 0.20 1"/>
          <geom class="hull" mesh="s3_stator_l" pos="0 0 0.13" quat="1 0 0 0"/>
          <geom class="visual" mesh="s3_retainer_l" pos="0 0 0.13" quat="1 0 0 0" rgba="0.55 0.55 0.6 1"/>
          <geom class="hull" mesh="s3_retainer_l" pos="0 0 0.13" quat="1 0 0 0"/>
          <geom class="visual" mesh="s3_idler_a_l" pos="0 0 0.13" quat="1 0 0 0" rgba="0.25 0.25 0.25 1"/>
          <geom class="hull" mesh="s3_idler_a_l" pos="0 0 0.13" quat="1 0 0 0"/>
          <geom class="visual" mesh="s3_idler_b_l" pos="0 0 0.13" quat="1 0 0 0" rgba="0.25 0.25 0.25 1"/>
          <geom class="hull" mesh="s3_idler_b_l" pos="0 0 0.13" quat="1 0 0 0"/>
          <inertial pos="-2.92859e-05 0.000813 0.0716414" mass="0.32309" diaginertia="0.000858336 0.000809362 0.000234358"/>
          <body gravcomp="1" name="l_S3" pos="0 0 0.13" quat="1 0 0 0">
            <joint name="l_S3" class="roll" axis="-0 -0 -1" range="-1.39626 1.39626"/>
            <geom class="visual" mesh="s3_rotor_l" pos="0 0 0" quat="1 0 0 0" rgba="0.30 0.55 0.85 1"/>
            <geom class="hull" mesh="s3_rotor_l" pos="0 0 0" quat="1 0 0 0"/>
            <geom class="visual" mesh="link_upper_l" pos="0 0 0.043" quat="1 0 0 0" rgba="0.80 0.80 0.82 1"/>
            <geom class="hull" mesh="link_upper_l" pos="0 0 0.043" quat="1 0 0 0"/>
            <geom class="visual" mesh="e_base_l" pos="0 0 0.17" quat="0.707107 0 0 -0.707107" rgba="0.85 0.45 0.20 1"/>
            <geom class="hull" mesh="e_base_l" pos="0 0 0.17" quat="0.707107 0 0 -0.707107"/>
            <inertial pos="2.49818e-09 2.88352e-06 0.0723249" mass="0.20334" diaginertia="0.000539678 0.000540431 0.000102885"/>
            <body gravcomp="1" name="l_E" pos="0 0 0.17" quat="0.707107 0 0 -0.707107">
              <joint name="l_E" class="hinge" axis="1 -0 -0" range="0.00000 2.00713"/>
              <geom class="visual" mesh="e_rotor_a_l" pos="0 0 0" quat="1 0 0 0" rgba="0.30 0.55 0.85 1"/>
              <geom class="hull" mesh="e_rotor_a_l" pos="0 0 0" quat="1 0 0 0"/>
              <geom class="visual" mesh="e_rotor_b_l" pos="0 0 0" quat="1 0 0 0" rgba="0.30 0.55 0.85 1"/>
              <geom class="hull" mesh="e_rotor_b_l" pos="0 0 0" quat="1 0 0 0"/>
              <geom class="visual" mesh="link_e_f_l" pos="0 0 0.057" quat="1 0 0 0" rgba="0.80 0.80 0.82 1"/>
              <geom class="hull" mesh="link_e_f_l" pos="0 0 0.057" quat="1 0 0 0"/>
              <geom class="visual" mesh="f_stator_l" pos="0 0 0.119" quat="1 0 0 0" rgba="0.85 0.45 0.20 1"/>
              <geom class="hull" mesh="f_stator_l" pos="0 0 0.119" quat="1 0 0 0"/>
              <geom class="visual" mesh="f_retainer_l" pos="0 0 0.119" quat="1 0 0 0" rgba="0.55 0.55 0.6 1"/>
              <geom class="hull" mesh="f_retainer_l" pos="0 0 0.119" quat="1 0 0 0"/>
              <geom class="visual" mesh="f_idler_a_l" pos="0 0 0.119" quat="1 0 0 0" rgba="0.25 0.25 0.25 1"/>
              <geom class="hull" mesh="f_idler_a_l" pos="0 0 0.119" quat="1 0 0 0"/>
              <geom class="visual" mesh="f_idler_b_l" pos="0 0 0.119" quat="1 0 0 0" rgba="0.25 0.25 0.25 1"/>
              <geom class="hull" mesh="f_idler_b_l" pos="0 0 0.119" quat="1 0 0 0"/>
              <inertial pos="-3.95009e-05 0.000884428 0.0739051" mass="0.22164" diaginertia="0.000502203 0.000487643 0.000137574"/>
              <body gravcomp="1" name="l_F" pos="0 0 0.119" quat="1 0 0 0">
                <joint name="l_F" class="roll" axis="-0 -0 -1" range="-1.48353 1.48353"/>
                <geom class="visual" mesh="f_rotor_l" pos="0 0 0" quat="1 0 0 0" rgba="0.30 0.55 0.85 1"/>
                <geom class="hull" mesh="f_rotor_l" pos="0 0 0" quat="1 0 0 0"/>
                <geom class="visual" mesh="link_forearm_l" pos="0 0 0.043" quat="1 0 0 0" rgba="0.80 0.80 0.82 1"/>
                <geom class="hull" mesh="link_forearm_l" pos="0 0 0.043" quat="1 0 0 0"/>
                <geom class="visual" mesh="w1_base_l" pos="0 0 0.131" quat="1 0 0 0" rgba="0.85 0.45 0.20 1"/>
                <geom class="hull" mesh="w1_base_l" pos="0 0 0.131" quat="1 0 0 0"/>
                <inertial pos="-1.74505e-09 3.45649e-06 0.0592679" mass="0.13717" diaginertia="0.000202848 0.000203181 4.555e-05"/>
                <body gravcomp="1" name="l_W1" pos="0 0 0.131" quat="1 0 0 0">
                  <joint name="l_W1" class="hinge" axis="1 -0 -0" range="-1.04720 1.04720"/>
                  <geom class="visual" mesh="w1_rotor_a_l" pos="0 0 0" quat="1 0 0 0" rgba="0.30 0.55 0.85 1"/>
                  <geom class="hull" mesh="w1_rotor_a_l" pos="0 0 0" quat="1 0 0 0"/>
                  <geom class="visual" mesh="w1_rotor_b_l" pos="0 0 0" quat="1 0 0 0" rgba="0.30 0.55 0.85 1"/>
                  <geom class="hull" mesh="w1_rotor_b_l" pos="0 0 0" quat="1 0 0 0"/>
                  <geom class="visual" mesh="link_w1_w2_l" pos="0 0 0.041" quat="1 0 0 0" rgba="0.80 0.80 0.82 1"/>
                  <geom class="hull" mesh="link_w1_w2_l" pos="0 0 0.041" quat="1 0 0 0"/>
                  <geom class="visual" mesh="w2_base_l" pos="0 0 0.11" quat="0.707107 0 0 -0.707107" rgba="0.85 0.45 0.20 1"/>
                  <geom class="hull" mesh="w2_base_l" pos="0 0 0.11" quat="0.707107 0 0 -0.707107"/>
                  <inertial pos="7.39973e-10 2.21963e-09 0.050337" mass="0.11592" diaginertia="0.00011502 0.000109365 3.29e-05"/>
                  <body gravcomp="1" name="l_W2" pos="0 0 0.11" quat="0.707107 0 0 -0.707107">
                    <joint name="l_W2" class="hinge" axis="1 -0 -0" range="-1.57080 1.57080"/>
                    <geom class="visual" mesh="w2_rotor_a_l" pos="0 0 0" quat="1 0 0 0" rgba="0.30 0.55 0.85 1"/>
                    <geom class="hull" mesh="w2_rotor_a_l" pos="0 0 0" quat="1 0 0 0"/>
                    <geom class="visual" mesh="w2_rotor_b_l" pos="0 0 0" quat="1 0 0 0" rgba="0.30 0.55 0.85 1"/>
                    <geom class="hull" mesh="w2_rotor_b_l" pos="0 0 0" quat="1 0 0 0"/>
                    <geom class="visual" mesh="gripper_palm_l" pos="0 0 0.041" quat="1 0 0 0" rgba="0.35 0.75 0.45 1"/>
                    <geom class="hull" mesh="gripper_palm_l" pos="0 0 0.041" quat="1 0 0 0"/>
                    <inertial pos="-0.000107402 -0.000264226 0.0724738" mass="0.05087" diaginertia="1.08287e-05 1.08287e-05 1.59699e-05"/>
                    <site name="l_tool" pos="0 0 0.113" quat="1 0 0 0" size="0.006" rgba="1 0.2 0.2 0.6" group="3"/>
                    <camera name="l_wrist" pos="0 -0.048 0.059" xyaxes="-1 0 0 0 0.896268 -0.443514" fovy="80"/>
                    <body gravcomp="1" name="l_finger_a" pos="0.02 0 0.071" quat="1 0 0 0">
                      <joint name="l_finger_a" class="finger" axis="-0 1 -0" range="0 0.71558"/>
                      <geom class="visual" mesh="gripper_finger_a_l" pos="-0.02 0 -0.03" quat="1 0 0 0" rgba="0.35 0.75 0.45 1"/>
                      <geom class="visual" mesh="gripper_pad_a_l" pos="-0.02 0 -0.03" quat="1 0 0 0" rgba="0.15 0.15 0.15 1"/>
                      <geom name="l_pad_a" class="pad" type="box" size="0.00545 0.00875 0.016875" pos="-0.0142 0 0.040875" quat="1 0 0 0"/>
                      <inertial pos="-0.02 0 0.03" mass="0.015" diaginertia="4e-6 4e-6 1e-6"/>
                    </body>
                    <body gravcomp="1" name="l_finger_b" pos="-0.02 0 0.071" quat="1 0 0 0">
                      <joint name="l_finger_b" class="finger" axis="-0 -1 -0" range="0 0.71558"/>
                      <geom class="visual" mesh="gripper_finger_b_l" pos="0.02 0 -0.03" quat="1 0 0 0" rgba="0.35 0.75 0.45 1"/>
                      <geom class="visual" mesh="gripper_pad_b_l" pos="0.02 0 -0.03" quat="1 0 0 0" rgba="0.15 0.15 0.15 1"/>
                      <geom name="l_pad_b" class="pad" type="box" size="0.00545 0.00875 0.016875" pos="0.0142 0 0.040875" quat="1 0 0 0"/>
                      <inertial pos="0.02 0 0.03" mass="0.015" diaginertia="4e-6 4e-6 1e-6"/>
                    </body>
                  </body>
                </body>
              </body>
            </body>
          </body>
        </body>
      </body>
      </body>
  </worldbody>
  <contact>
    <exclude body1="r_finger_a" body2="r_finger_b"/>
    <exclude body1="l_finger_a" body2="l_finger_b"/>
  </contact>
  <equality>
    <joint joint1="r_finger_b" joint2="r_finger_a" polycoef="0 1 0 0 0" solref="0.005 1"/>
    <joint joint1="l_finger_b" joint2="l_finger_a" polycoef="0 1 0 0 0" solref="0.005 1"/>
  </equality>
  <actuator>
    <position name="r_S1" joint="r_S1" kp="120.0" kv="9.6" forcerange="-20.0 20.0" ctrlrange="-0.52360 2.09440"/>
    <position name="r_S2" joint="r_S2" kp="120.0" kv="9.6" forcerange="-20.0 20.0" ctrlrange="-0.17453 1.74533"/>
    <position name="r_S3" joint="r_S3" kp="40.0" kv="3.2" forcerange="-10.0 10.0" ctrlrange="-1.39626 1.39626"/>
    <position name="r_E" joint="r_E" kp="60.0" kv="4.8" forcerange="-12.0 12.0" ctrlrange="0.00000 2.00713"/>
    <position name="r_F" joint="r_F" kp="15.0" kv="1.2" forcerange="-6.0 6.0" ctrlrange="-1.48353 1.48353"/>
    <position name="r_W1" joint="r_W1" kp="12.0" kv="0.96" forcerange="-5.0 5.0" ctrlrange="-1.04720 1.04720"/>
    <position name="r_W2" joint="r_W2" kp="8.0" kv="0.64" forcerange="-4.0 4.0" ctrlrange="-1.57080 1.57080"/>
    <position name="r_gripper" joint="r_finger_a" kp="3" kv="0.05" forcerange="-0.6 0.6" ctrlrange="0 0.71558"/>
    <position name="l_S1" joint="l_S1" kp="120.0" kv="9.6" forcerange="-20.0 20.0" ctrlrange="-0.52360 2.09440"/>
    <position name="l_S2" joint="l_S2" kp="120.0" kv="9.6" forcerange="-20.0 20.0" ctrlrange="-0.17453 1.74533"/>
    <position name="l_S3" joint="l_S3" kp="40.0" kv="3.2" forcerange="-10.0 10.0" ctrlrange="-1.39626 1.39626"/>
    <position name="l_E" joint="l_E" kp="60.0" kv="4.8" forcerange="-12.0 12.0" ctrlrange="0.00000 2.00713"/>
    <position name="l_F" joint="l_F" kp="15.0" kv="1.2" forcerange="-6.0 6.0" ctrlrange="-1.48353 1.48353"/>
    <position name="l_W1" joint="l_W1" kp="12.0" kv="0.96" forcerange="-5.0 5.0" ctrlrange="-1.04720 1.04720"/>
    <position name="l_W2" joint="l_W2" kp="8.0" kv="0.64" forcerange="-4.0 4.0" ctrlrange="-1.57080 1.57080"/>
    <position name="l_gripper" joint="l_finger_a" kp="3" kv="0.05" forcerange="-0.6 0.6" ctrlrange="0 0.71558"/>
  </actuator>
</mujoco>
