paszkowskiDamian/tendon-torso/(commit log)

2026-11-10 J1: parametric 1-DOF tendon hinge test rig, research notes, torso roadmap
    [assembly_preview.step, base.step, base.stl, distal_half.step, distal_half.stl, proximal.step, proximal.stl, spool.step]
2026-11-10 Add animated 3D viewer; fix spool tendon anchors
    The spool's two anchor holes were both cut on the same groove and on the
    wrong (top) side. Tendons arrive from above, so they wrap under the spool:
    anchors now sit at -135 deg on each groove.
    [assembly_preview.step, base.step, base.stl, distal_a.stl, distal_b.stl, distal_half.step, proximal.step, proximal.stl]
2026-11-10 Viewer: load meshes as compact JSON
    [base.stl, distal_a.stl, distal_b.stl, proximal.stl, spool.stl]
2026-11-10 J1-S: stepper hinge with 6:1 tendon reduction and Bowden-ready centre
    - drum r36 / helical spool r6 on a NEMA17 (6:1, ~1.6 N*m usable)
    - 14 mm x r28 open cavity for up to 3 PTFE Bowden tubes (bend R>=25)
    - tapered proximal link following the converging tendons
    - shared CAD helpers in joints/common, checks in tools/check_j1s.py
    [assembly_preview.step, base.step, base.stl, distal_half.step, distal_half.stl, proximal.step, proximal.stl, spool.step]
2026-11-10 J1b: second DOF - J2 wrist module driven by Bowden cables
    - J2: r20 drum on 608s, 3.33:1 with the shared r6 helical spool, +/-110 deg
    - J2 mount bolts onto a new J1-S distal flange (90-deg symmetric pattern:
    parallel or perpendicular wrist), angled tube sockets aimed along the
    drum tangents
    - standalone Bowden-drive module (NEMA17 + spool + tube sockets)
    - J1-S variants: through-holes in the proximal cap, mount-flange end
    - fix: proximal() cap variant was shadowed by a local variable
    - tools/check_j1b.py: range, cord and fit checks
    [assembly_preview.step, base.step, bowden_drive.step, bowden_drive.stl, distal_half.step, j1_distal_half_mount.step, j1_distal_half_mount.stl, j1_proximal_through.step]
2026-11-10 Viewer: add J1b two-joint tab with Bowden tubes and both motors
    - hash tabs #j1 / #j1b, two sliders, drive readout
    - tools/export_viewer.py regenerates all viewer meshes
2026-11-10 Viewer: add 7-DOF human-like arm concept tab with hand-crank bank
    - shoulder cable differential (S1/S2), upper-arm and forearm roll rings,
    elbow, 2-DOF wrist; Bowden tubes routed through every joint centre
    - 7 cranks in the torso with per-joint ratios and live turn counts
    - viewer refactored: per-model joint sliders and badges
2026-11-10 Arm: full 7-DOF hand-cranked tendon arm, all parts printable
    - arm/ package: hinge module family (S1, S2, elbow, W1, W2), roll module
    family (upper-arm rotation, forearm twist) on thin-section bearings with
    623 idlers, tapered links with outward bolting lips, crank modules with
    10-deg lock pin and tension block, shoulder beam and crank racks
    - 37 print-oriented STLs + PRINT_LIST.md, all <= 250 mm bed
    - tools/check_arm.py: joint limits, combined poses, crank clearance,
    tube passages, tendon tension estimates (all pass)
    - viewer: Arm tab now shows the real CAD with cords, tubes and cranks
    - build guide with BOM, tube/cord lengths and assembly order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
    [crank_arm.stl, crank_frame.stl, crank_knob.stl, crank_lock_pin.stl, crank_nut_cup.stl, crank_socket_block.stl, crank_spool.stl, e_base.stl]
2026-11-10 tools/printability.py: support-free printability gate for print-oriented STLs
    Baseline on the arm: 19/37 parts pass (arm/printability_baseline.json).
2026-11-10 Roll joints: support-free S3/F stator, rotor, retainer
    - stator bore wall 6.5 mm (r_in = r_t - 6.5): retainer screws get 1.6/2.85 mm
    walls, stator pilots 2.0 mm; tube stops 0.4 mm below the upper inner race so
    the retainer clamps the race; shoulder and retainer stay off the 2RS seals
    - idler cheeks: 45 deg buttresses, spacer bosses for the 623 inner race,
    bolt self-taps into the inner cheek (M3x12, no nut next to the drum)
    - rotor (printed upside down): upper seat on the outer race only + steep cone
    instead of a flat 5.6 mm ceiling, lower-pocket relief over the inner race,
    45 deg chamfered groove ceilings, teardrop anchor channels/knot pockets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
    [f_retainer.stl, f_rotor.stl, f_stator.stl, s3_retainer.stl, s3_rotor.stl, s3_stator.stl]
2026-11-10 Arm: support-free crank, link and torso parts
    - crank spool: one solid of revolution (shallow open helix grooves, 48 deg cones
    under every flange), prints standing on its -X boss; anchors at helix ends
    - crank frame: 48 deg roof under the beam (7 mm bridge), steeper teardrops,
    6 mm index holes (3 mm floor), pointed window in wall A; beam raised 4 mm
    - socket block: lowered, top chamfers, M4 nut traps at x=+-10.5 rotated flats-out
    - nut cup thicker (2.9 mm over the nut), lock pin shortened to the 6 mm holes
    - links: full 48 deg cone under the top lip with head counterbores from below,
    flaring links keep the narrow tube and widen the bore below the top lip,
    key counterbores from the bo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
    [crank_frame.stl, crank_lock_pin.stl, crank_nut_cup.stl, crank_socket_block.stl, crank_spool.stl, link_e_f.stl, link_forearm.stl, link_s1_s2.stl]
2026-11-10 hinge rotors: print plate-down, support-free
    Split-face-down printing makes the drum end cap cantilever over the open
    tube window (~40 mm), which no roof shape fixes. Rotor halves now print
    top plate down (rotX 180): neck spans full drum width and covers the drum
    top to 44 deg, groove runs as a 2.4 mm tunnel through the neck, tube
    window widened to [-138,-42] deg so no cavity roof is steeper than 45 deg,
    608 pockets / axle clearance / lightening holes are 50 deg teardrops,
    cavity-bearing wall 1 -> 1.6 mm (hub_half +0.6).
    Needs arm/export.py rotor orientation changed to rotX(a/b, 180).
    [hinge.py]
2026-11-10 Export hinge rotor halves top plate down (support-free orientation)
2026-11-10 Crank spool: 0.5 mm deep rounded-V grooves, pitch 1.9
    Cord centre stays at R_SPOOL = 8 (core r 8.0, groove bottom r 7.5, 45 deg flanks,
    ~0.48 mm flat lands), ~3.4 turns per section. Grooved cores are cut as separate
    Z-built rings and fused in (direct cut gave a broken shell). Sockets follow the
    new section centres.
    [crank_frame.stl, crank_socket_block.stl, crank_spool.stl]
2026-11-10 Arm: all 37 parts print without supports; integrate printability work
    Merged three parallel efforts:
    - hinges: rotors print top plate down, teardrop bearing pockets, 1.6 mm
    walls, neck covers the drum top (cord runs in a short channel)
    - roll joints: retainer walls, true bearing preload, idler cheeks with
    45-deg buttresses, rotor reshaped for upside-down printing
    - cranks/links/torso: one-body spool with 0.5 mm grooves, 48-deg beam
    roof, captive nuts with real walls, cone-supported link lips
    tools/printability.py: 37/37 PASS (arm/printability_report.json)
    tools/check_arm.py: all PASS
    Docs, viewer meshes and assembly render updated.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
    [e_base.stl, e_rotor_a.stl, e_rotor_b.stl, s1_base.stl, s1_rotor_a.stl, s1_rotor_b.stl, s2_base.stl, s2_rotor_a.stl]
2026-11-10 Roll idlers: drill the M3 through the 623 spacer bosses
    The boss and cheek bolt cuts left a 0.15-0.2 mm membrane in each spacer
    boss, so the idler bolt could not pass. Cut 3.2 mm through both bosses,
    face to face of the cheeks. Printability (7/7) and check_arm unchanged.
    [f_stator.stl, s3_stator.stl]
2026-11-10 Kinematics: FK from the CAD chain, Jacobian, IK solver, viewer reach mode
    - arm/kinematics.py: forward kinematics (identical to the CAD placement),
    geometric Jacobian, damped least-squares IK with joint-limit active set
    and null-space centring; position or full pose; crank turns per joint
    - arm/ik.py: CLI (python -m arm.ik X Y Z [--rpy R P Y] | --fk q1..q7)
    - tools/check_ik.py: FK vs CAD, Jacobian vs finite differences, IK round
    trips (150/150 position, 150/150 pose, ~4 ms), workspace
    - docs/kinematics.md: chain table, equations, method, crank mapping
    - viewer: Reach mode drives the hand; the same solver runs in JS
2026-11-10 Viewer: draggable gimbal on the hand target, pose IK in the browser
    - X/Y/Z arrows and the ball drag the hand; rotation rings twist it
    - browser IK now solves position or full pose (same method as Python)
    - fix: animation loop no longer dies while the arm data is loading
2026-11-10 Hinge rotors: cut the free-cord band out of the neck
    The straight cord from each Bowden socket to its drum tangent is fixed in
    the base. Near the end of the range where a cord is almost unwound its
    tangent point moves under the neck, which then pressed on the cord
    (S1 half B at 110-120 deg, E half B at 115 deg). Cut the band the cord
    sweeps over the whole range out of the neck, in the groove plane, as
    wide as the groove (2.4 mm bridge roof, still support-free).
    All 15 hinge STLs pass tools/printability.py; check_arm all PASS.
    [e_rotor_a.stl, e_rotor_b.stl, s1_rotor_a.stl, s1_rotor_b.stl, s2_rotor_a.stl, s2_rotor_b.stl, w1_rotor_a.stl, w1_rotor_b.stl]
2026-11-10 Statics, low-lever IK, DOF study, live loads in the viewer
    - arm/statics.py: mass model from the CAD (+hardware, tubes, payload),
    gravity torques, cord tensions, crank-knob force, bearing radial loads,
    link bending stress, flange bolt loads; worst cases over the workspace
    (docs/loads_report.txt)
    - arm/kinematics.py: ik_low_lever / optimize_posture use the spare joints
    to minimise the sum of squared cord tensions (shorter gravity levers)
    - tools/dof_study.py: 7 vs 6 vs 5 DOF - mass, shoulder torque, reach
    - viewer: live gravity-load table, 'prefer short levers' in reach mode
    [kinematics.py, statics.py]
2026-11-10 Cord mounting: per-cord socket blocks, crank tube clip, labelled tube combs, cord thimble
    - crank: socket block split into A (+y) and B (-y), one M4x45 + captive nut each,
    screw at the same y as its cord, guided by both walls, 10 mm travel, top follows
    the roof; frame tension holes moved accordingly
    - crank_tube_clip: washer plate under both screw heads with 15 mm tube sleeves
    - torso: snap-in tube comb (7x2 labelled grid) for the beam windows at y=33/60
    - fittings.cord_thimble(): teardrop thimble for cord to spring hook / eye
    - export + README updated; 41/41 parts pass printability
    [crank_frame.stl, crank_socket_block.stl, crank_socket_block_a.stl, crank_socket_block_b.stl, crank_tube_clip.stl, fitting_cord_thimble.stl, torso_tube_comb.stl]
2026-11-10 Shoulder gravity balance: zero-length springs on S1
    Yoke arms on link_s1_s2 (same flanges/length, kinematics unchanged) carry cord
    pins B at x=+-85, b=81 mm; cords run over sheaves on two beam-wall masts a=113 mm
    above S1, back to 0.26 N/mm extension springs on table posts with M5 eye-bolt
    tuning. Mass model from CAD volumes (2.0 kg, d=389 mm, 7.6 N*m). Minimax
    k*a*b=4.75 N*m: S1 peak 7.6 -> 2.9 N*m (-62%) over S1xS2xE. Racks moved to
    x=220. New checks: tools/check_balance.py, check_arm balance section.
    [balance_mast_l.stl, balance_mast_r.stl, balance_post.stl, balance_sheave.stl, link_s1_s2.stl]
2026-11-11 Weight optimisation: 2.17 -> 1.59 kg, S1 worst case 10.4 -> 7.8 N*m
    - Elbow + wrist hinges on 625 bearings / M5 stub axles (bearing and axle are
    now HingeSpec parameters; shoulder keeps 608 / M8), smaller lugs
    - One mass model for statics and balance: solid skin + per-part infill
    (links 3 walls + 15 %, modules 4 walls + 25 %)
    - Link walls 3 -> 2 mm
    - XL / XM roll-stator flanges sized to the Bowden sockets (lip dia 126 -> 113,
    122 -> 108 mm)
    - Balance spring re-tuned for the lighter arm: 0.18 N/mm (1.2 mm wire), masts
    unchanged; S1 peak 5.06 -> 1.85 N*m (-63 %)
    - README: weight section, print profiles, hardware, roll-joint mounting note;
    loads report and viewer meshes regenerated
    A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
    [e_base.stl, e_rotor_a.stl, e_rotor_b.stl, f_stator.stl, fitting_cord_thimble.stl, link_e_f.stl, link_forearm.stl, link_s1_s2.stl]
2026-11-11 Viewer: cutaway of the roll joints (bearings, stator tube, retainer) with zoom buttons
2026-11-11 Viewer IK: follow the hand from the current posture, no more sudden jumps
    The reach-mode solver kept whichever of 8 random/mid starts landed closest,
    so a slightly short continuation lost to a different arm posture and the arm
    flipped. Now: continue from the current posture first; other starts only when
    it cannot follow, and a switch only if that really reaches. Big posture
    changes are animated. Live moves get a small low-lever budget per step; the
    full optimisation runs on release.
    Sweep test (445 small target steps): 64 jumps (max 150 deg) -> 4 animated
    reconfigurations at joint limits.
2026-11-11 Roll stators: inclined Bowden sockets, much slimmer S3/F plates and links
    Fixes the previous commit's flange shrink, which put both roll sockets ~4.5 mm
    outside the link bore (socket is at idler_y + idler cord radius, not idler_y).
    The sockets now lean 45 deg inwards: the cord leaves the idler at its
    lower-outer side and runs under it, so it exits the plate at r 34.7 (S3) /
    32.2 (F) instead of 44.8 / 42.5. S3 sits on the L flange (link_s2_s3 is a
    straight L tube), F on a new ML class (tube_r 38). Plates 126 -> 104 mm and
    122 -> 100 mm. Cheek buttresses moved to the inner side, clear of the drum.
    check_arm tubes now verifies each roll socket exit lies inside the link bore.
    Arm 1.56 kg; all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
    [f_stator.stl, fitting_cord_thimble.stl, link_e_f.stl, link_s2_s3.stl, s3_stator.stl]
2026-11-11 Gripper: two geared fingers on one cord + opening spring, 8th crank
    - arm/gripper.py: palm (bolts on W2 like a link lip, Bowden socket in the
    centre boss), two angular fingers synchronised by gear sectors (m 1.25,
    r 20), cord drum R 20 on finger A fed straight up the axis, extension
    spring between the finger tails opens, open stops at 41 deg, slide-on
    pads (TPU or PETG). 0..62 mm opening, 10 N per pad at 42-44 N of cord,
    51 g incl. hardware.
    - Chain: gripper is the last element (in = out = 0); TOOL_OFFSET 60 -> 72
    = grasp centre. Gripper tube adds 1 to tubes_through S1..W2; slot_y 6.5
    on S1, S2, E, W1.
    - 8th crank (G) in rack 3 middle slot, ratio 2.5:1, cord on helix A only.
    -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
    [e_base.stl, e_rotor_a.stl, e_rotor_b.stl, fitting_cord_thimble.stl, gripper_finger_a.stl, gripper_finger_b.stl, gripper_pad.stl, gripper_palm.stl]
2026-11-11 W2 range +-90 (hand dexterity x2 per work-area study); tube bend check through hinges (currently fails S1/E/W1/W2 - being fixed)
    [specs.py]
2026-11-11 Work-area study with gripper + W2 +-90: table 625-700 mm below the shoulder, 300x525 mm work area, shoulder spacing ~350 mm
2026-11-11 Hinges: tube window sized for the passing tubes' bends; bend check in check_arm
    Every hinge now passes tools/check_tube_bends.py (W2 at +-90):
    - R_MIN = 19.05 mm (3/4") from the Pexco Altaflo 100 PTFE datasheet,
    2 x 4 mm metric row 100-0157-040; was an unsourced 25 mm estimate.
    - Path model: besides the centred placement, try the bundle pushed to the
    outer side of the bend within its slots (where a bent tube rides), the
    better one counts; finer radius list; runs the limits in parallel.
    - Rotor tube window: widened on both sides by a slot-wide band so the
    whole bundle clears the sleeve near the axis (W1 was blocked, W2 tight).
    - S1 and E (HingeSpec.neck_window=("hi",)): window opened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
    [e_rotor_a.stl, e_rotor_b.stl, s1_rotor_a.stl, s1_rotor_b.stl, s2_rotor_a.stl, s2_rotor_b.stl, w1_rotor_a.stl, w1_rotor_b.stl]
2026-11-11 Two-arm torso: drive column of 16 servo units, mirrored left arm, tube bend budget
    - arm/drive.py: drive-unit family (crank spool on 608 + 6805, two-pin hub, per-motor
    horn adapter and cup for STS3215/STS3250/STS3095 and the DM-J4310 upgrade)
    - arm/torso.py: 2020/2040 torso, 7-level saddle column, S1 hangers under the clavicle,
    shoulder beams with tube combs, electronics tray, E-stop bracket
    - arm/assembly.py: torso placement, mirrored left arm, drive frames, tube routes
    - tools/check_arm.py: drives, bends, torso (arm-vs-arm, arm-vs-torso) checks
    - viewer: torso, second arm, drive column replace the crank bank
    [arm_drive_motor_dmj4310.json, arm_drive_motor_sts3095.json, arm_drive_motor_sts3215.json, arm_drive_motor_sts3250.json, balance_post.stl, crank_arm.stl, crank_frame.stl, crank_knob.stl]
2026-11-11 MuJoCo sim: both arms from the CAD, pick-and-place, LeRobot demos, ACT at 84%
    - sim/build_model.py: robot.xml + meshes from arm/ (chain, limits, masses, mirrored
    left arm, coupled gripper fingers, wrist cameras); tool FK matches arm.kinematics
    - sim/scene.xml, sim/env.py: table, cube, bin, cameras; 16-d joint-target actions
    - sim/scripted.py: top-down IK pick-and-place, joint-space consistent grasps,
    DART noise on free moves; 100/100 right arm, 50/50 both arms
    - sim/record.py: LeRobot v3 datasets, parallel workers; sim/eval_policy.py
    - ACT on 200 demos, 30k steps: 42/50 unseen scenes with whole-chunk execution
    - docs/sim.md with setup (Python 3.12 + torch 2.9.1 for training) and findings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
    [e_base_l.stl, e_base_r.stl, e_rotor_a_l.stl, e_rotor_a_r.stl, e_rotor_b_l.stl, e_rotor_b_r.stl, f_idler_a_l.stl, f_idler_a_r.stl]
